jamilchahineaub/FireFightingUAVF26-27/cl415/cad/interference.md

# CAD interference check

Pairs whose bounding boxes overlap, with the volume their solids share.

| part A | part B | shared volume [mm^3] |
|---|---|---|
| fuselage | left_wing | 0.000 |
| fuselage | right_wing | 0.000 |
| fuselage | v_stab | 0.000 |
| fuselage | rudder | 0.000 |
| fuselage | water_tank | 0.000 |
| fuselage | eq_avionics | 0.000 |
| fuselage | eq_elevator_servo | 0.000 |
| fuselage | eq_rudder_servo | 0.000 |
| fuselage | eq_door_servo | 0.000 |
| left_wing | right_wing | 0.000 |
| left_wing | left_aileron | 0.000 |
| left_wing | left_nacelle | 0.000 |
| left_wing | left_float | 0.000 |
| left_wing | eq_left_aileron_servo | 0.000 |
| right_wing | right_aileron | 0.000 |
| right_wing | right_nacelle | 0.000 |
| right_wing | right_float | 0.000 |
| right_wing | eq_right_aileron_servo | 0.000 |
| h_stab | elevator | 0.000 |
| h_stab | v_stab | 0.000 |
| elevator | v_stab | 0.000 |
| elevator | rudder | 0.000 |
| v_stab | rudder | 0.000 |
| left_nacelle | left_propeller | 0.000 |
| left_nacelle | eq_left_motor | 0.000 |
| left_nacelle | eq_left_esc | 0.000 |
| right_nacelle | right_propeller | 0.000 |
| right_nacelle | eq_right_motor | 0.000 |
| right_nacelle | eq_right_esc | 0.000 |

Largest overlap: 0.000 mm^3.
