jamilchahineaub/FireFightingUAVF26-27/cl415/flight_params/airfoils/report.md

# Airfoil properties (XFOIL)

XFOIL 6.99, viscous, free transition with Ncrit = 9 (clean model surface, low-turbulence air), incompressible. Polars in `polars/*.csv`, plots in `plots/`. Generated by `run_xfoil.py`.

## Reynolds numbers in flight

| V [m/s] | wing (c = 0.278 m) | h-stab (c = 0.239 m) | fin MAC (0.310 m) |
|---:|---:|---:|---:|
| 12 | 228k | 196k | 255k |
| 14 | 267k | 229k | 297k |
| 17 | 324k | 278k | 361k |
| 20 | 381k | 327k | 424k |
| 25 | 476k | 409k | 530k |
| 30 | 571k | 491k | 637k |

## NACA 4417 (wing)

| Re | alpha_L0 [deg] | cl_alpha [/rad] | cl_max | alpha at cl_max [deg] | cl_min | cd_min | cl at cd_min | cm0 (c/4) | x_ac/c | (cl/cd)max | cl at (cl/cd)max |
|---:|---:|---:|---:|---:|---:|---:|---:|---:|---:|---:|---:|
| 150k | -3.90 | 7.035 | 1.513 | 13.50 | -0.712 | 0.0144 | 0.405 | -0.1008 | 0.257 | 58 | 1.31 |
| 200k | -4.19 | 6.497 | 1.512 | 13.50 | -0.859 | 0.0122 | 0.441 | -0.1044 | 0.246 | 68 | 1.35 |
| 300k | -4.32 | 6.135 | 1.528 | 14.00 | -0.959 | 0.0103 | 0.475 | -0.1053 | 0.236 | 81 | 1.26 |
| 400k | -4.32 | 6.034 | 1.547 | 14.50 | -1.011 | 0.0094 | 0.551 | -0.1046 | 0.234 | 90 | 1.25 |
| 500k | -4.31 | 6.046 | 1.567 | 14.75 | -1.020 | 0.0088 | 0.580 | -0.1039 | 0.236 | 97 | 1.21 |
| 600k | -4.30 | 6.085 | 1.584 | 14.75 | -1.021 | 0.0084 | 0.610 | -0.1033 | 0.237 | 103 | 1.23 |

Aileron effectiveness at Re 300k, hinge at 0.750 c (cf/c = 0.250), deflections -10, -5, +5, +10 deg: dcl/ddelta = 3.100 /rad, dcm/ddelta = -0.479 /rad, tau = 0.505 (thin-airfoil theory says 0.609). Extra drag at 10 deg: 0.0061.

## NACA 0016 (htail)

| Re | alpha_L0 [deg] | cl_alpha [/rad] | cl_max | alpha at cl_max [deg] | cl_min | cd_min | cl at cd_min | cm0 (c/4) | x_ac/c | (cl/cd)max | cl at (cl/cd)max |
|---:|---:|---:|---:|---:|---:|---:|---:|---:|---:|---:|---:|
| 150k | 0.00 | 7.826 | 1.203 | 13.75 | -1.200 | 0.0135 | -0.000 | -0.0000 | 0.267 | 45 | 0.80 |
| 200k | 0.00 | 6.811 | 1.218 | 15.00 | -1.185 | 0.0111 | -0.000 | 0.0000 | 0.245 | 50 | 0.83 |
| 300k | 0.00 | 6.102 | 1.242 | 17.50 | -1.184 | 0.0091 | -0.000 | 0.0000 | 0.226 | 57 | 0.86 |
| 400k | 0.00 | 6.007 | 1.249 | 17.75 | -1.211 | 0.0082 | -0.000 | 0.0000 | 0.226 | 63 | 0.94 |
| 500k | 0.00 | 6.047 | 1.278 | 16.00 | -1.242 | 0.0077 | -0.000 | 0.0000 | 0.230 | 67 | 0.99 |
| 600k | 0.00 | 6.095 | 1.313 | 16.25 | -1.267 | 0.0073 | -0.000 | 0.0000 | 0.233 | 70 | 1.00 |

Elevator effectiveness at Re 300k, hinge at 0.603 c (cf/c = 0.397), deflections -10, -5, +5, +10 deg: dcl/ddelta = 4.603 /rad, dcm/ddelta = -0.557 /rad, tau = 0.754 (thin-airfoil theory says 0.746). Extra drag at 10 deg: 0.0067.

## NACA 0012 (fin)

| Re | alpha_L0 [deg] | cl_alpha [/rad] | cl_max | alpha at cl_max [deg] | cl_min | cd_min | cl at cd_min | cm0 (c/4) | x_ac/c | (cl/cd)max | cl at (cl/cd)max |
|---:|---:|---:|---:|---:|---:|---:|---:|---:|---:|---:|---:|
| 150k | 0.00 | 8.687 | 1.052 | 11.00 | -1.052 | 0.0119 | -0.382 | 0.0000 | 0.296 | 43 | 0.62 |
| 200k | 0.00 | 8.284 | 1.107 | 12.50 | -1.107 | 0.0102 | 0.000 | 0.0000 | 0.286 | 47 | 0.62 |
| 300k | 0.00 | 7.497 | 1.161 | 13.75 | -1.159 | 0.0077 | 0.000 | -0.0000 | 0.270 | 53 | 0.65 |
| 400k | -0.00 | 6.829 | 1.204 | 14.00 | -1.203 | 0.0067 | 0.000 | 0.0000 | 0.253 | 58 | 0.67 |
| 500k | -0.00 | 6.454 | 1.236 | 14.75 | -1.228 | 0.0062 | 0.000 | -0.0000 | 0.243 | 62 | 0.74 |
| 600k | -0.00 | 6.254 | 1.261 | 14.75 | -1.252 | 0.0059 | 0.000 | -0.0000 | 0.237 | 65 | 0.79 |

Rudder effectiveness at Re 300k, hinge at 0.620 c (cf/c = 0.380), deflections -10, -5, +5, +10 deg: dcl/ddelta = 4.565 /rad, dcm/ddelta = -0.585 /rad, tau = 0.609 (thin-airfoil theory says 0.732). Extra drag at 10 deg: 0.0061.
