jamilchahineaub/FireFightingUAVF26-27/docs/versions.md

# Pinned versions

Fill in on the simulation machine and keep current. Every log and result refers to this file.

| Item | Value | Recorded by | Date |
|---|---|---|---|
| OS (`lsb_release -a`) | | | |
| PX4-Autopilot tag (`git describe --tags`) | | | |
| PX4-gazebo-models submodule commit | | | |
| Gazebo (`gz sim --versions`) | | | |
| gz-sim includes AdvancedLiftDrag Cem fix (#3695) | | | |
| QGroundControl | | | |
| MATLAB / Octave | Octave 8.4.0 (dev container) | Jamil | 2026-09-28 |
| Python + pyyaml + jinja2 | Python 3.11 | Jamil | 2026-09-28 |
| params.yaml schema | 1 | Jamil | 2026-09-28 |
