jamilchahineaub/FireFightingUAVF26-27/cl415/cad/renders/cad_views.png

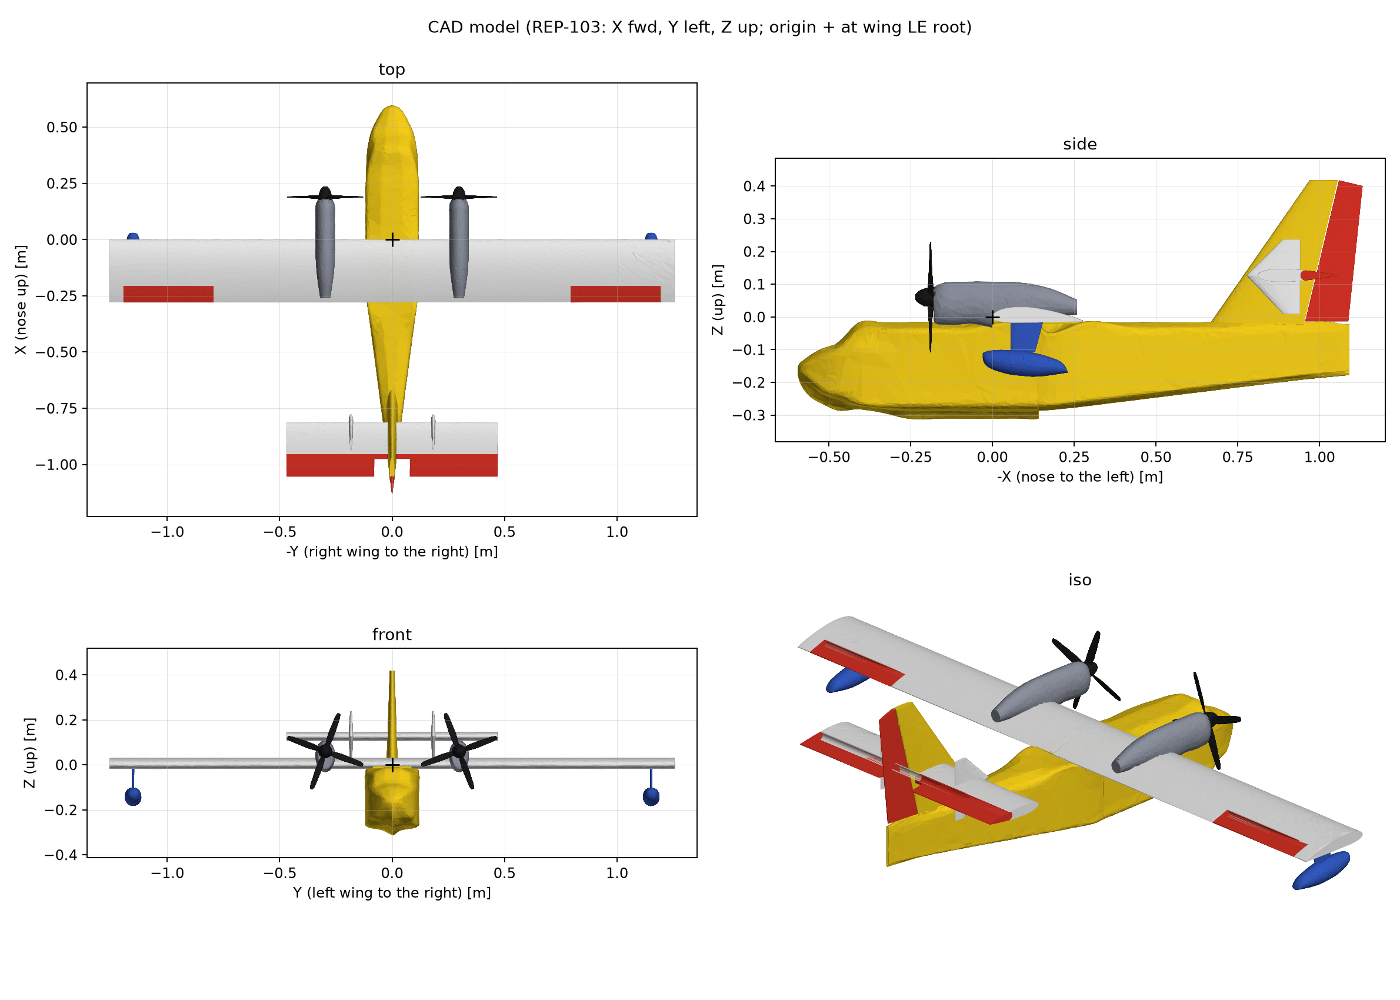
cl415/cad/renders/cad_views.png
