jamilchahineaub/FireFightingUAVF26-27/cl415/cad/renders/cad_vs_obj_front.png

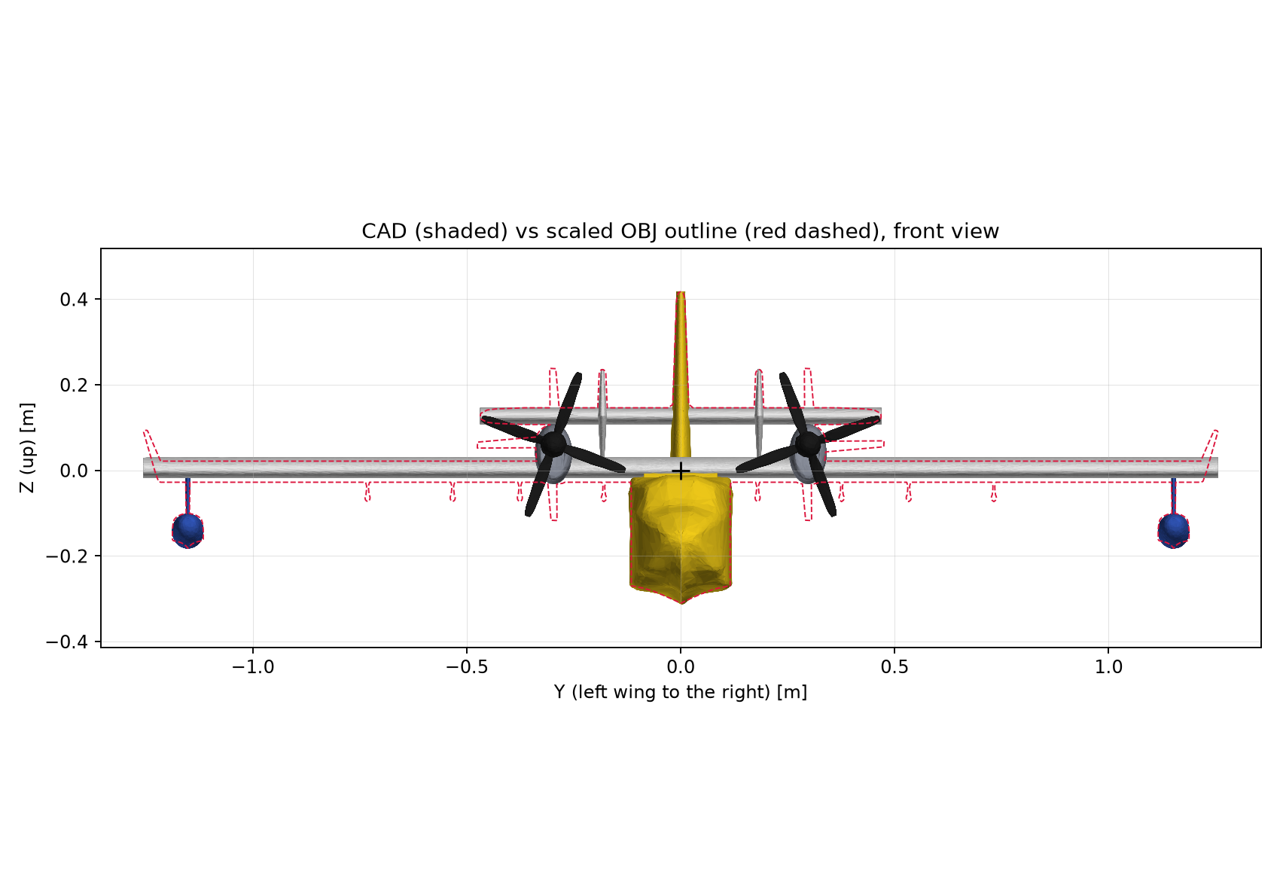
cl415/cad/renders/cad_vs_obj_front.png
