jamilchahineaub/FireFightingUAVF26-27/cl415/cad/renders/cad_vs_obj_side.png

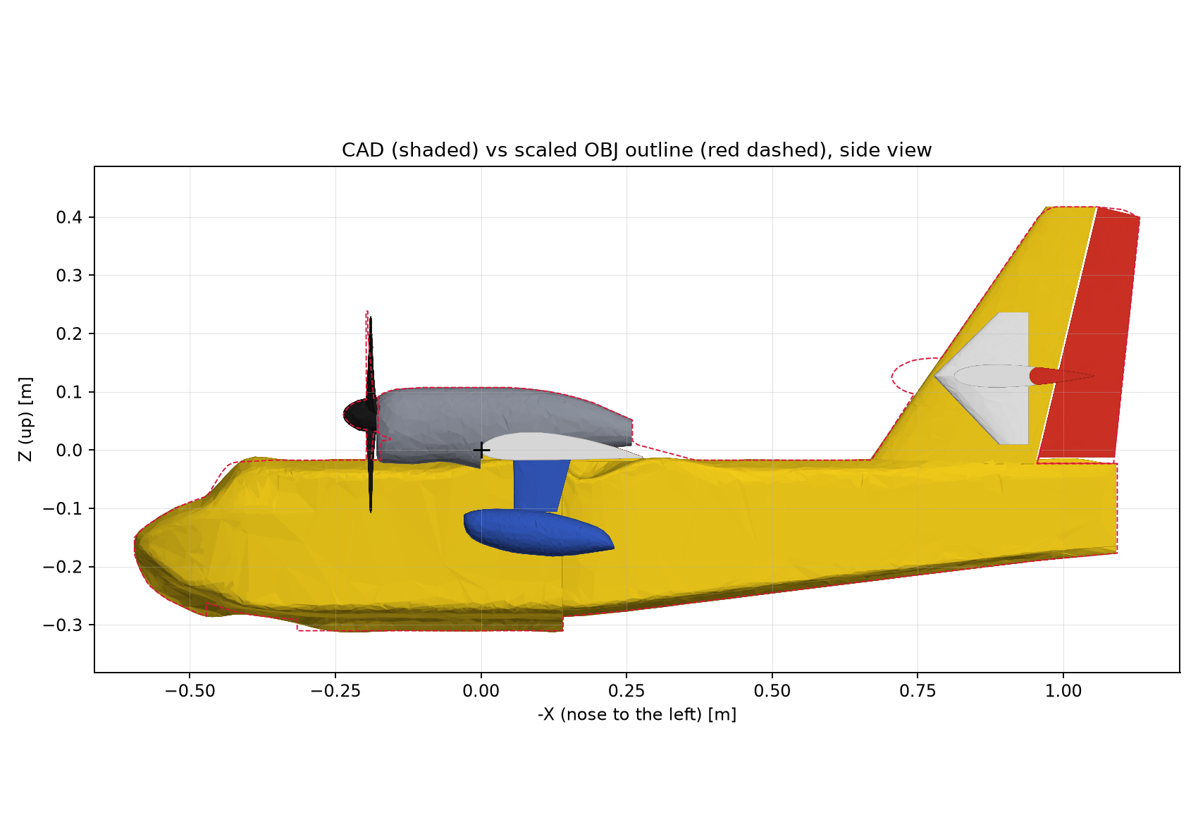
cl415/cad/renders/cad_vs_obj_side.png
