jamilchahineaub/FireFightingUAVF26-27/cl415/flight_params/airfoils/plots/fin_0012.png

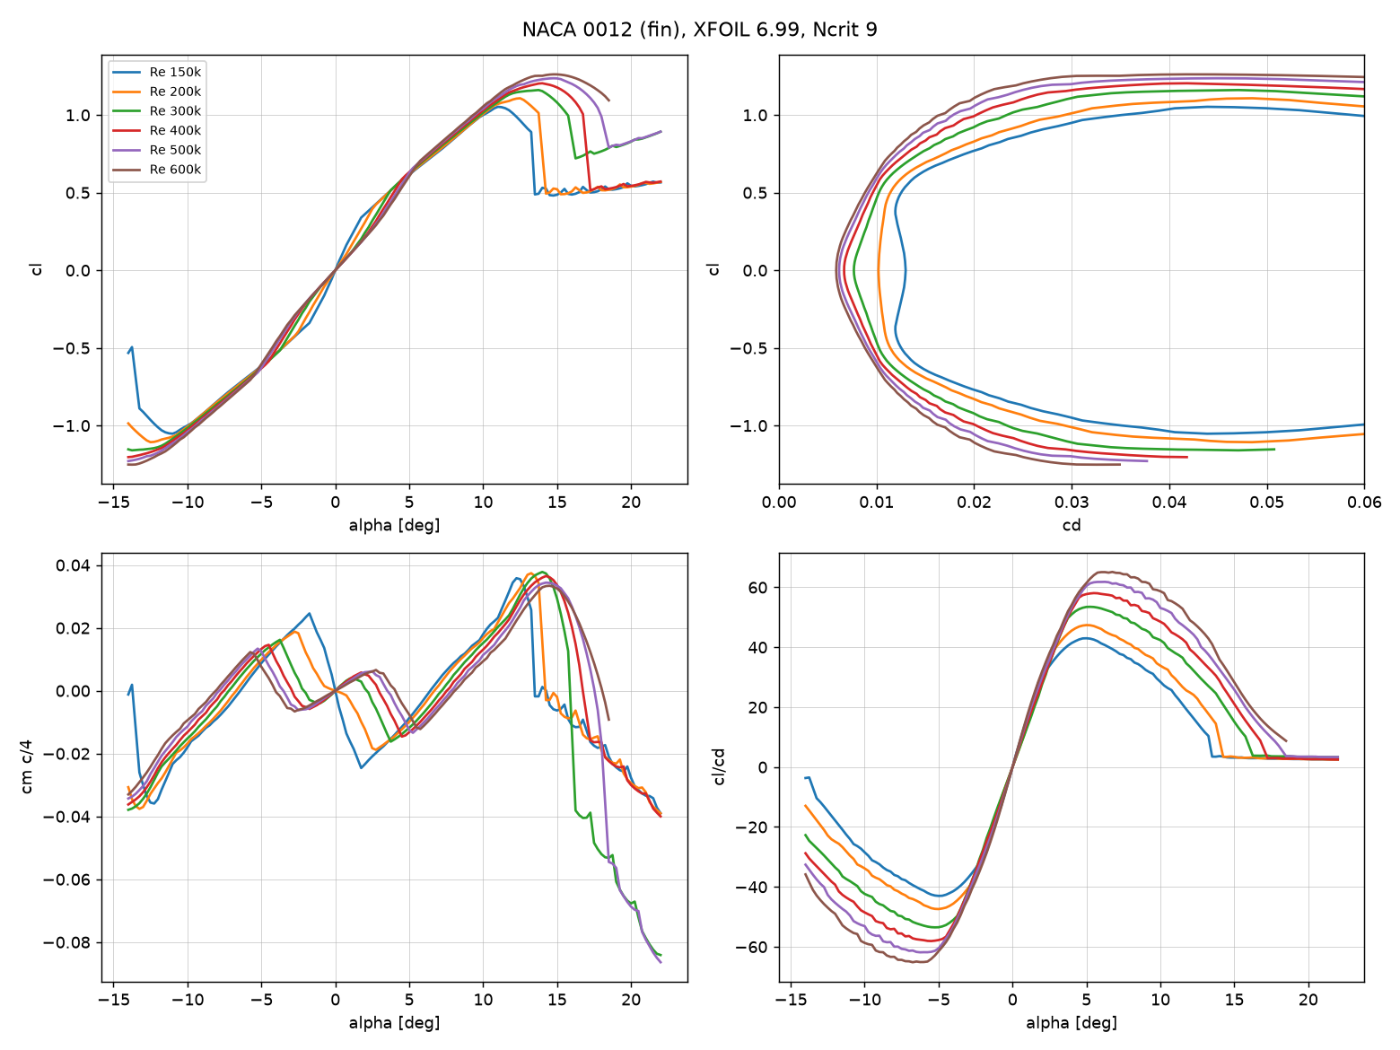
cl415/flight_params/airfoils/plots/fin_0012.png
