jamilchahineaub/FireFightingUAVF26-27/cl415/flight_params/airfoils/plots/htail_0016.png

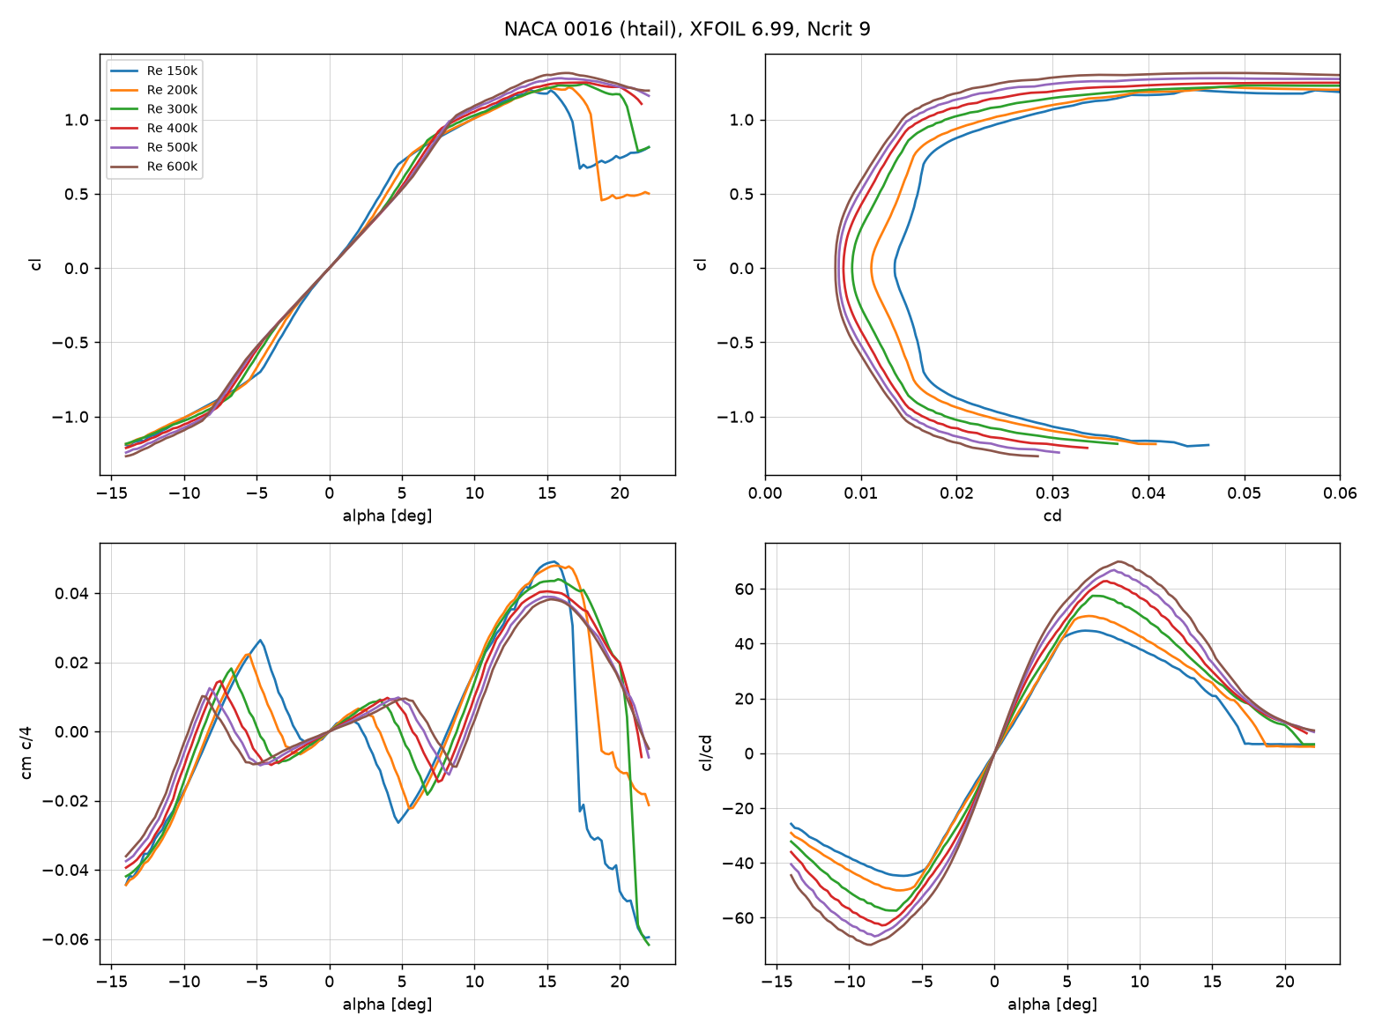
cl415/flight_params/airfoils/plots/htail_0016.png
