jamilchahineaub/FireFightingUAVF26-27/cl415/flight_params/airfoils/plots/wing_4417.png

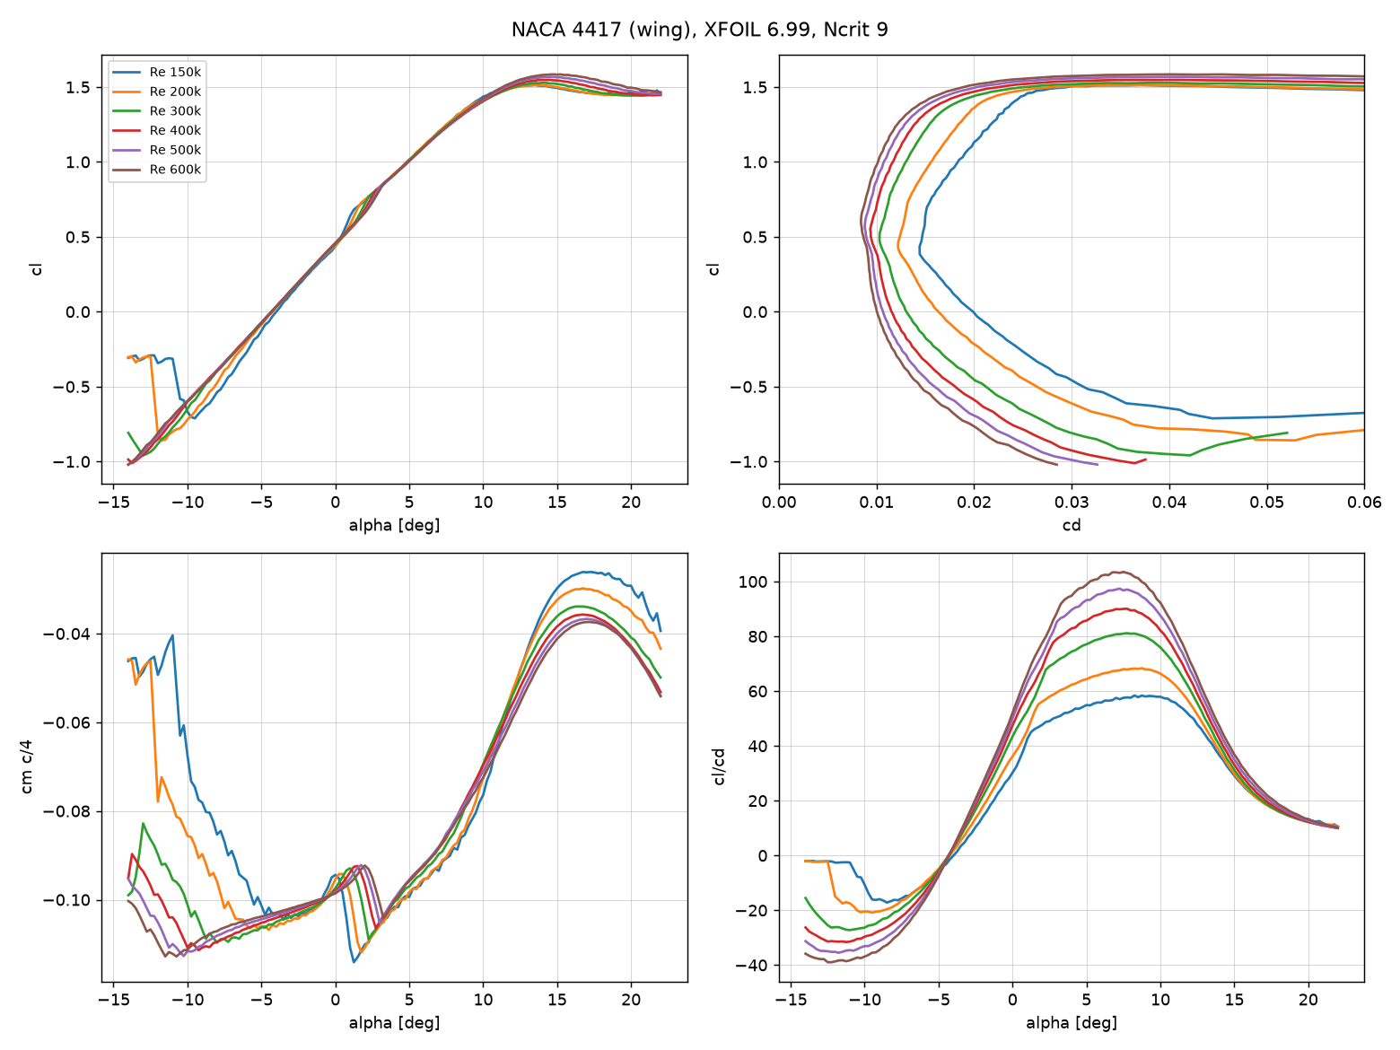
cl415/flight_params/airfoils/plots/wing_4417.png
