jamilchahineaub/FireFightingUAVF26-27/cl415/flight_params/plots/aero_and_thrust.png

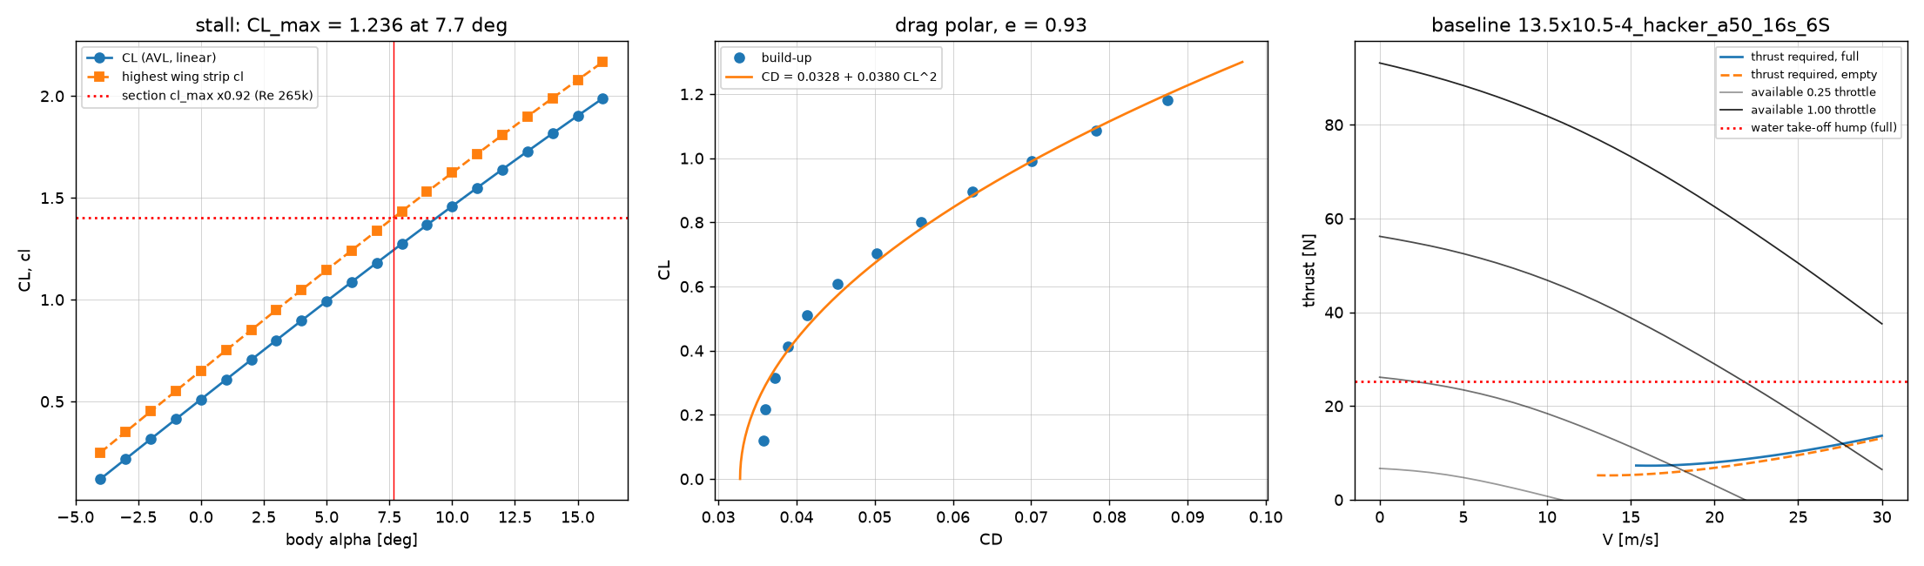
cl415/flight_params/plots/aero_and_thrust.png
