jamilchahineaub/FireFightingUAVF26-27/cl415/obj_inspect/renders/obj_raw_axes.png

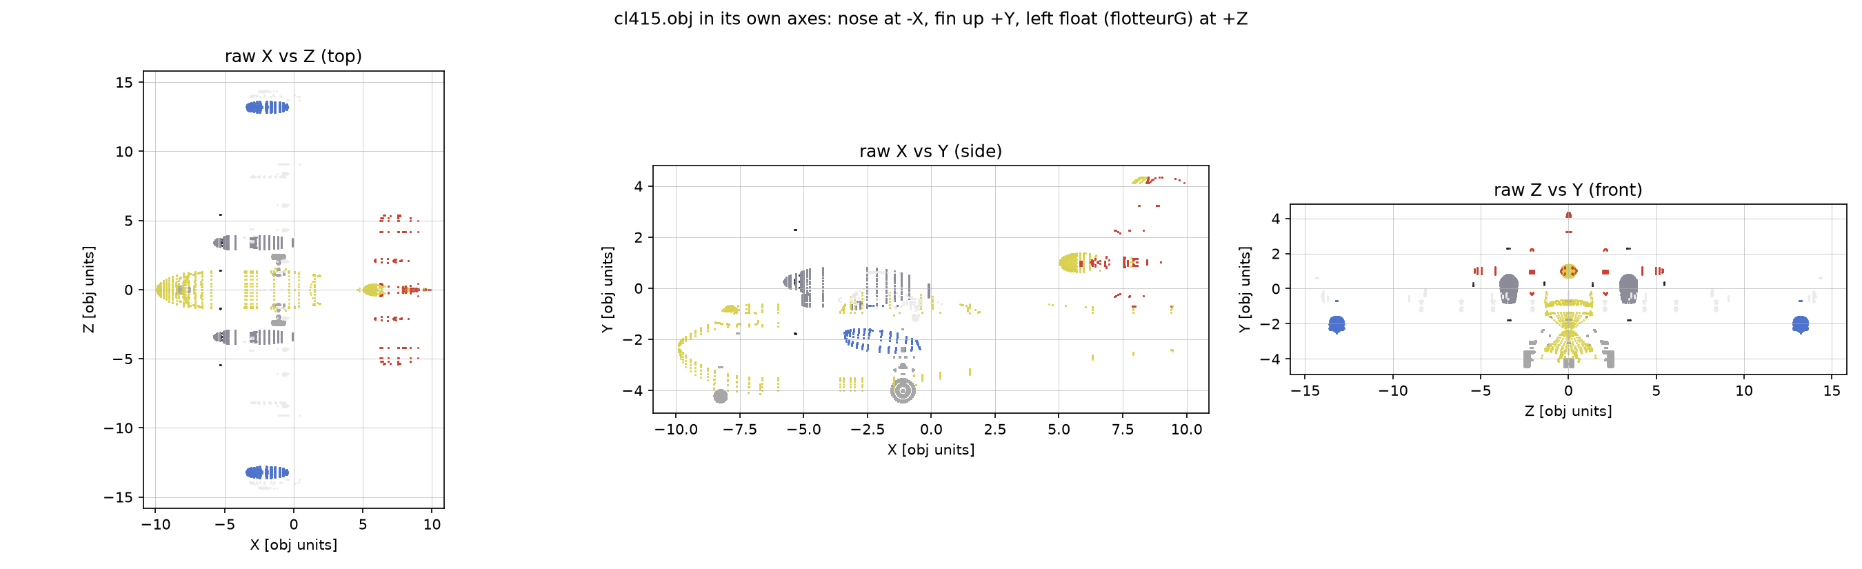
cl415/obj_inspect/renders/obj_raw_axes.png
