jamilchahineaub/FireFightingUAVF26-27/cl415/obj_inspect/renders/obj_top.png

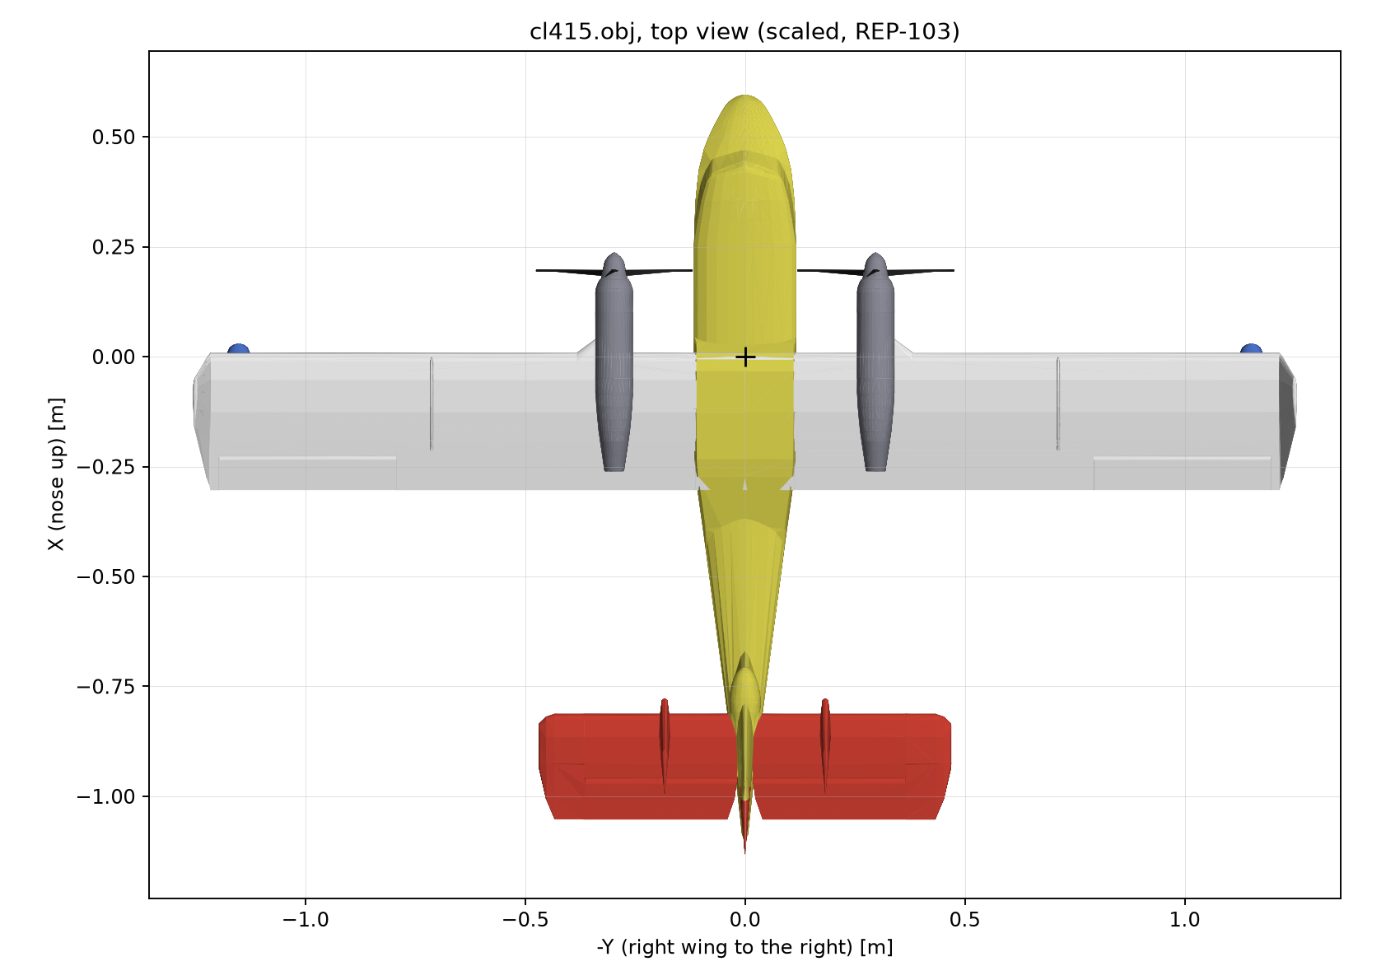
cl415/obj_inspect/renders/obj_top.png
