jamilchahineaub/FireFightingUAVF26-27/cl415/obj_inspect/renders/obj_views.png

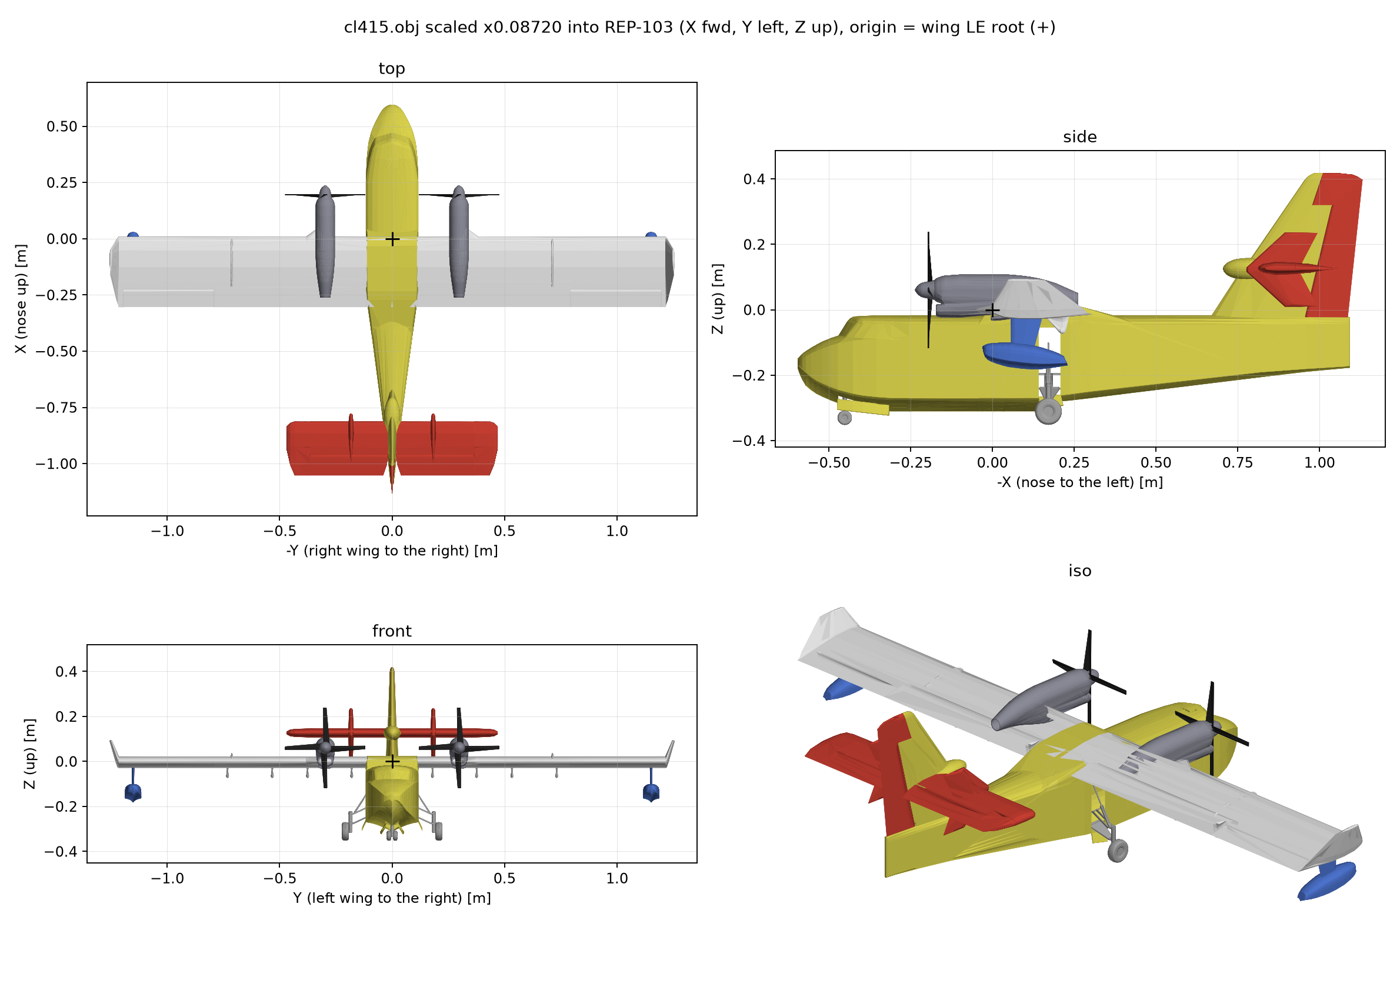
cl415/obj_inspect/renders/obj_views.png
