jamilchahineaub/FireFightingUAVF26-27/cl415/cad/cl415_assembly.step

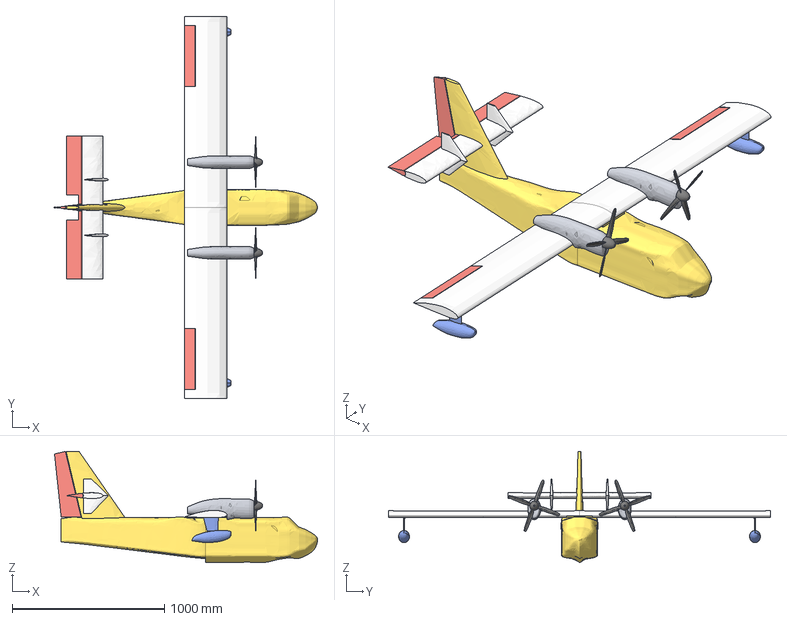
[picture p16: CAD file, 2026-10-05]
cl415/cad/cl415_assembly.step
1726.2 x 2510.0 x 729.7 mm
fuselage
left_wing
right_wing
left_aileron
right_aileron
h_stab
elevator
v_stab
rudder
left_nacelle
right_nacelle
left_propeller
right_propeller
left_float
right_float
water_tank
eq_left_motor
eq_right_motor
eq_left_esc
eq_right_esc
eq_left_aileron_servo
eq_right_aileron_servo
eq_avionics
eq_elevator_servo
eq_rudder_servo
eq_door_servo
