jamilchahineaub/FireFightingUAVF26-27/cl415/cad/build/hull_outer.step

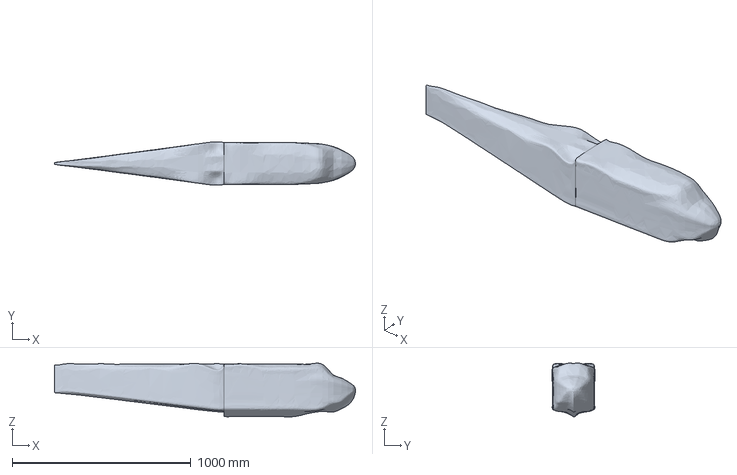
[picture p17: CAD file, 2026-10-05]
cl415/cad/build/hull_outer.step
1685.1 x 243.5 x 300.9 mm
