jamilchahineaub/FireFightingUAVF26-27/cl415/cad/parts/eq_left_aileron_servo.step

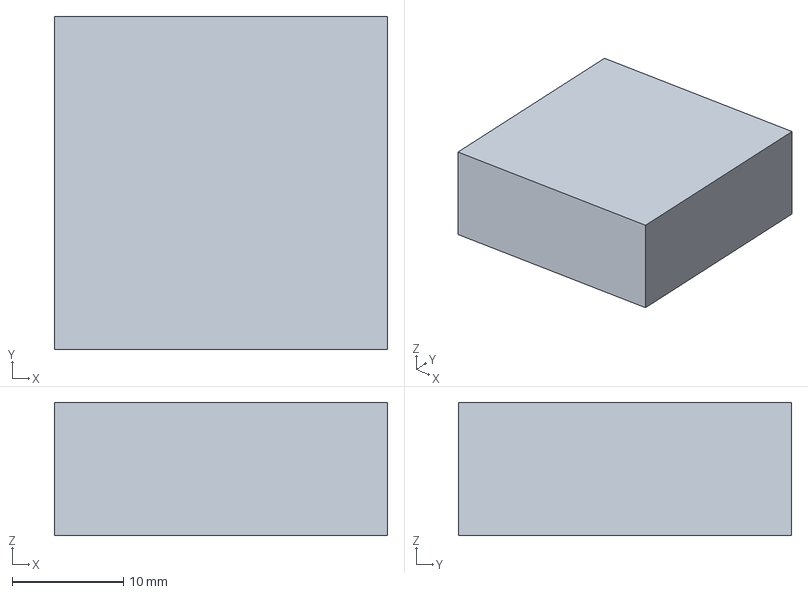
[picture p18: CAD file, 2026-10-05]
cl415/cad/parts/eq_left_aileron_servo.step
30.0 x 30.0 x 12.0 mm
