jamilchahineaub/FireFightingUAVF26-27/cl415/cl415.obj

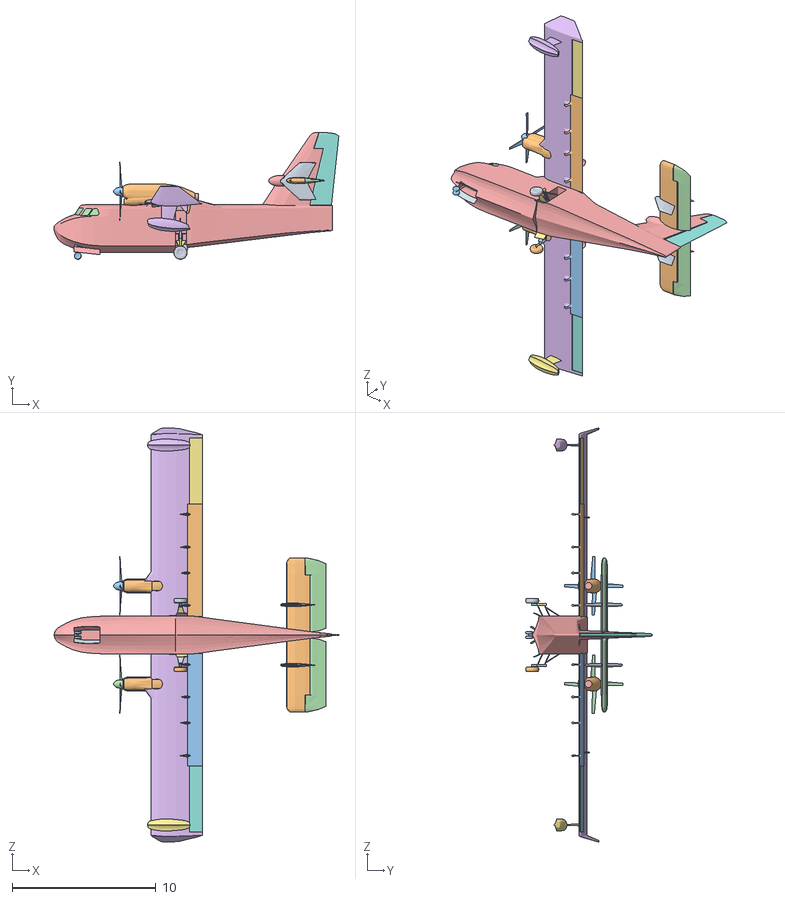
[picture p19: CAD file, 2026-10-05]
cl415/cl415.obj
19.8 x 8.82 x 28.8
porteD
voletG_voletG.mesh
voletD_voletD.mesh
vitres_vitres.mesh
trous_trous.mesh
trappeG_trappeG.mesh
trappeD_trappeD.mesh
surailes_surailes.mesh
roueG_roueG.mesh
roueD_roueD.mesh
roueA_roueA.mesh
profondeur_profondeur.mesh
porteG_porteG.mesh
parapG2_parapG2.mesh
parapG1_parapG1.mesh
parapD2_parapD2.mesh
parapD1_parapD1.mesh
moteurs_moteurs.mesh
heliceG_heliceG.mesh
heliceD_heliceD.mesh
fuselage_fuselage.mesh
flotteurG_flotteurG.mesh
flotteurD_flotteurD.mesh
direction_direction.mesh
derive2_derive2.mesh
derive_derive.mesh
bolG_bolG.mesh
bolD_bolD.mesh
axeG4_axeG4.mesh
axeG3_axeG3.mesh
axeG2_axeG2.mesh
axeG1_axeG1.mesh
axeD4_axeD4.mesh
axeD3_axeD3.mesh
axeD2_axeD2.mesh
axeD1_axeD1.mesh
axeA_axeA.mesh
ailes_ailes.mesh
aileronG_aileronG.mesh
aileronD_aileronD.mesh
planchet_planchet.mesh
inttour_inttour.mesh
interieur_interieur.mesh
cotes.001_cotes.mesh.001
cloison_cloison.mesh
vitre.012_vitre.mesh.012
tmp.002_tmp.mesh.002
tmp.001_tmp.mesh.001
vitre.011_vitre.mesh.011
vitre.010_vitre.mesh.010
tmp_tmp.mesh
face.005_face.mesh.005
fond.009_fond.mesh.009
needle.005_needle.mesh.005
vitre.009_vitre.mesh.009
vitre.008_vitre.mesh.008
needle.004_needle.mesh.004
fond.008_fond.mesh.008
face.004_face.mesh.004
bouton.001_bouton.mesh.001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
