jamilchahineaub/FireFightingUAVF26-27/cl415/cl415_description/meshes/left_nacelle.stl

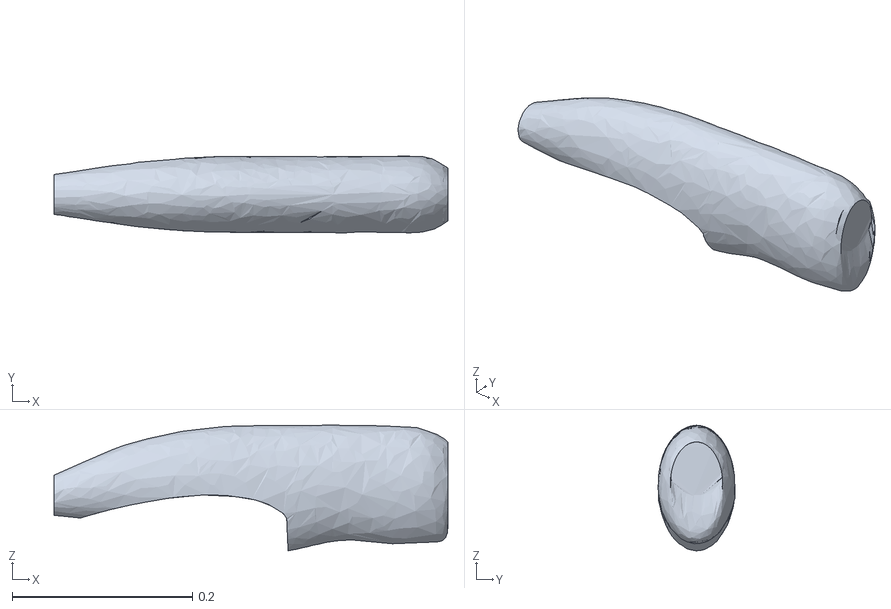
[picture p20: CAD file, 2026-10-05]
cl415/cl415_description/meshes/left_nacelle.stl
0.437 x 0.0851 x 0.139
