jamilchahineaub/FireFightingUAVF26-27/cl415/cad/build/hull_cavity.step

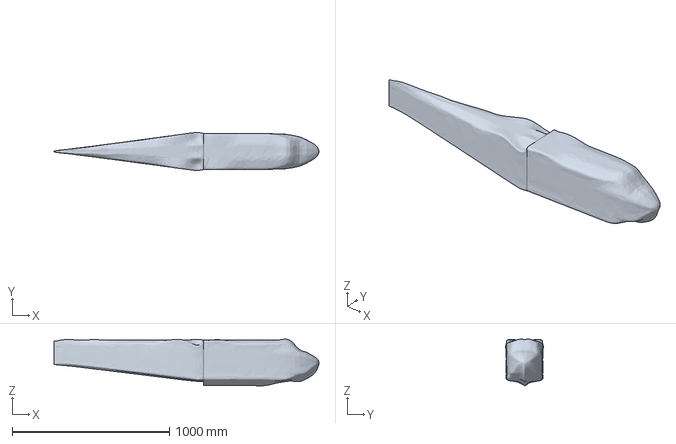
[picture p21: CAD file, 2026-10-05]
cl415/cad/build/hull_cavity.step
1685.1 x 240.5 x 297.0 mm
