jamilchahineaub/FireFightingUAVF26-27/cl415/cad/parts/eq_elevator_servo.step

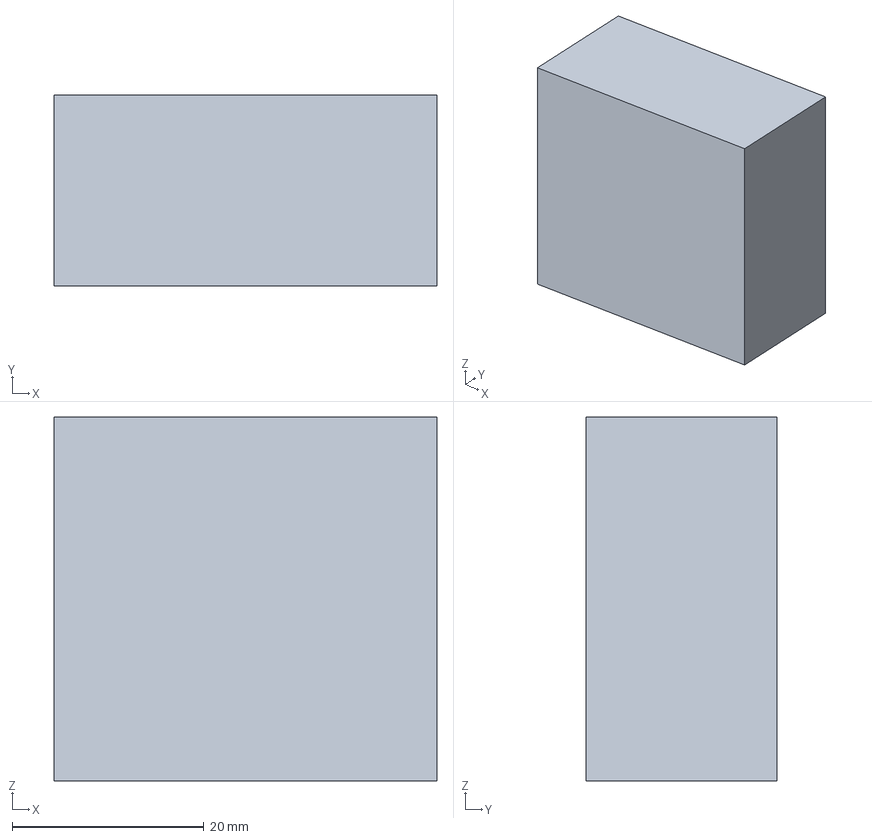
[picture p22: CAD file, 2026-10-05]
cl415/cad/parts/eq_elevator_servo.step
40.0 x 20.0 x 38.0 mm
