jamilchahineaub/FireFightingUAVF26-27/cl415/cl415_description/meshes/left_float.stl

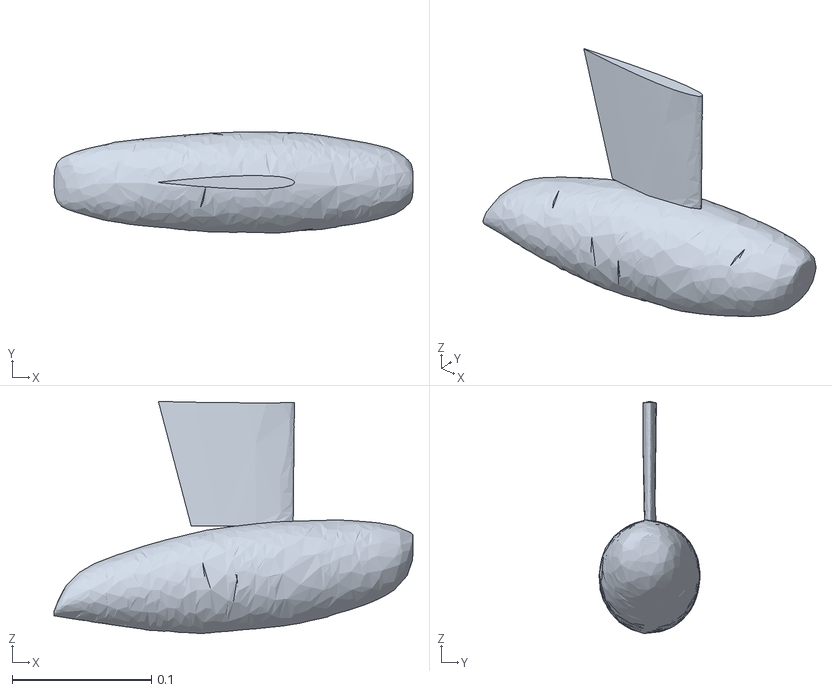
[picture p23: CAD file, 2026-10-05]
cl415/cl415_description/meshes/left_float.stl
0.257 x 0.0724 x 0.166
