jamilchahineaub/FireFightingUAVF26-27/cl415/cad/parts/left_float.step

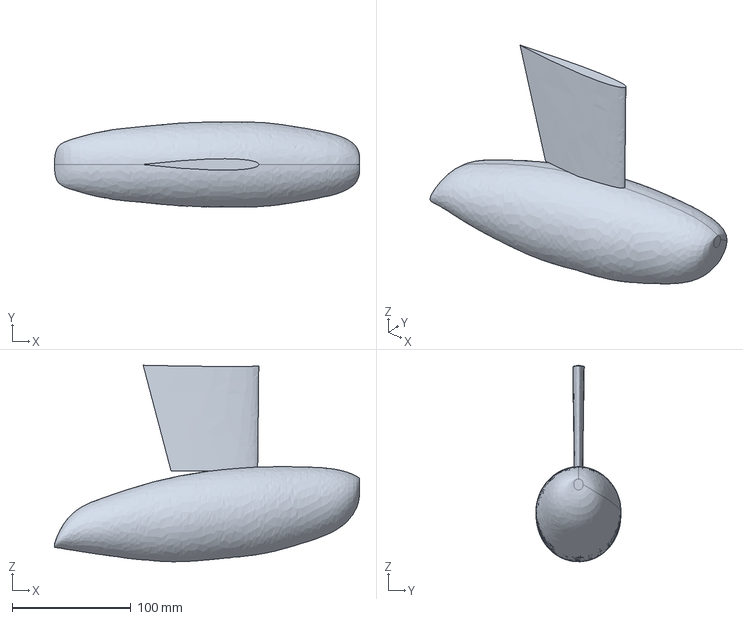
[picture p24: CAD file, 2026-10-05]
cl415/cad/parts/left_float.step
257.4 x 72.0 x 165.9 mm
