jamilchahineaub/FireFightingUAVF26-27/cl415/cl415_description/meshes/right_aileron.stl

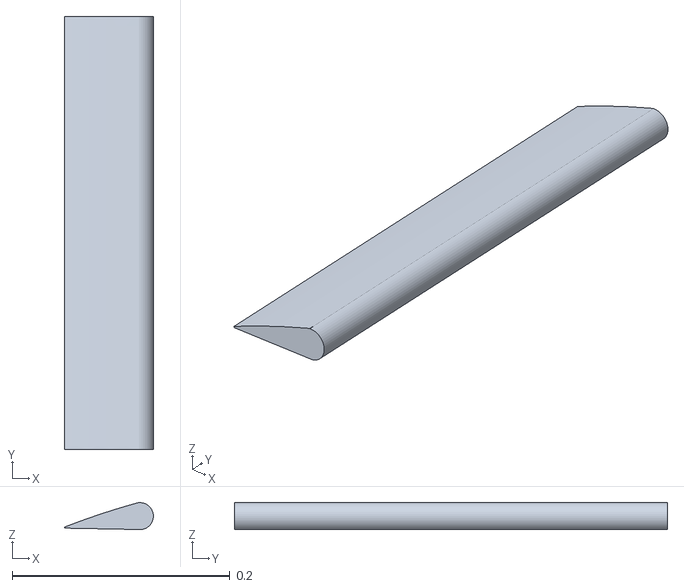
[picture p25: CAD file, 2026-10-05]
cl415/cl415_description/meshes/right_aileron.stl
0.0816 x 0.398 x 0.025
