jamilchahineaub/FireFightingUAVF26-27/cl415/cad/parts/eq_right_esc.step

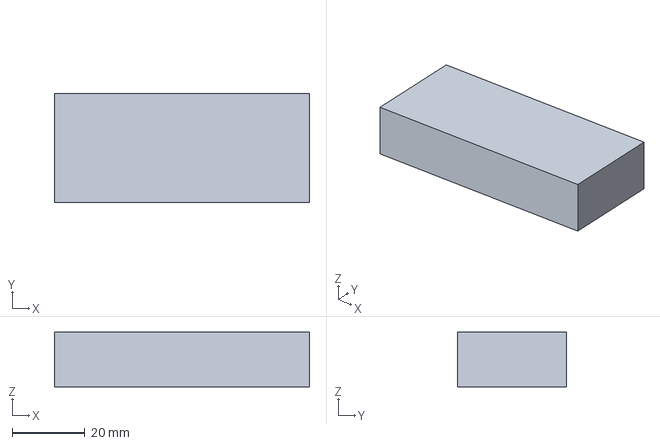
[picture p26: CAD file, 2026-10-05]
cl415/cad/parts/eq_right_esc.step
70.0 x 30.0 x 15.0 mm
