jamilchahineaub/FireFightingUAVF26-27/cl415/cad/parts/fuselage.step

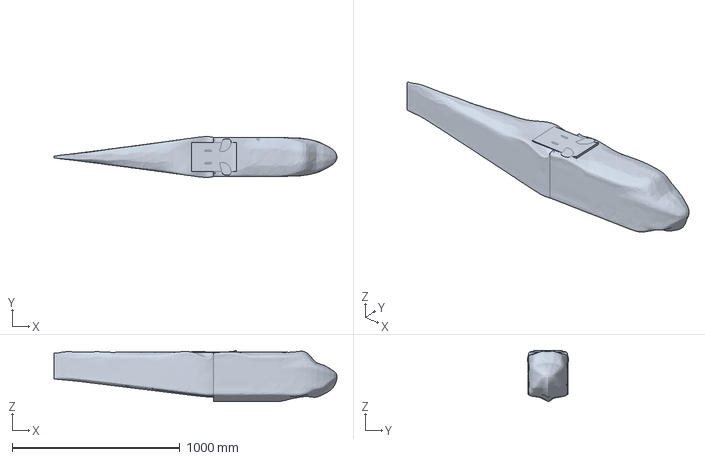
[picture p27: CAD file, 2026-10-05]
cl415/cad/parts/fuselage.step
1685.1 x 243.6 x 306.2 mm
