jamilchahineaub/FireFightingUAVF26-27/cl415/cl415_description/meshes/water_tank.stl

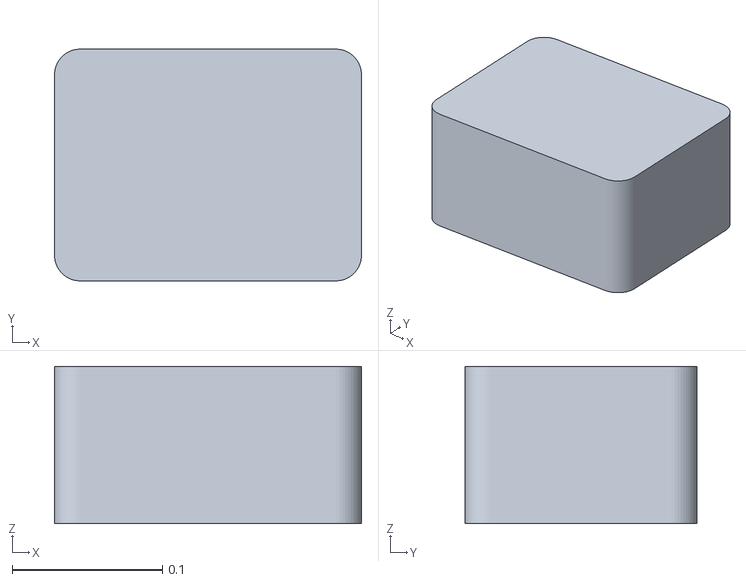
[picture p28: CAD file, 2026-10-05]
cl415/cl415_description/meshes/water_tank.stl
0.204 x 0.154 x 0.105
