jamilchahineaub/FireFightingUAVF26-27/cl415/cad/parts/left_wing.step

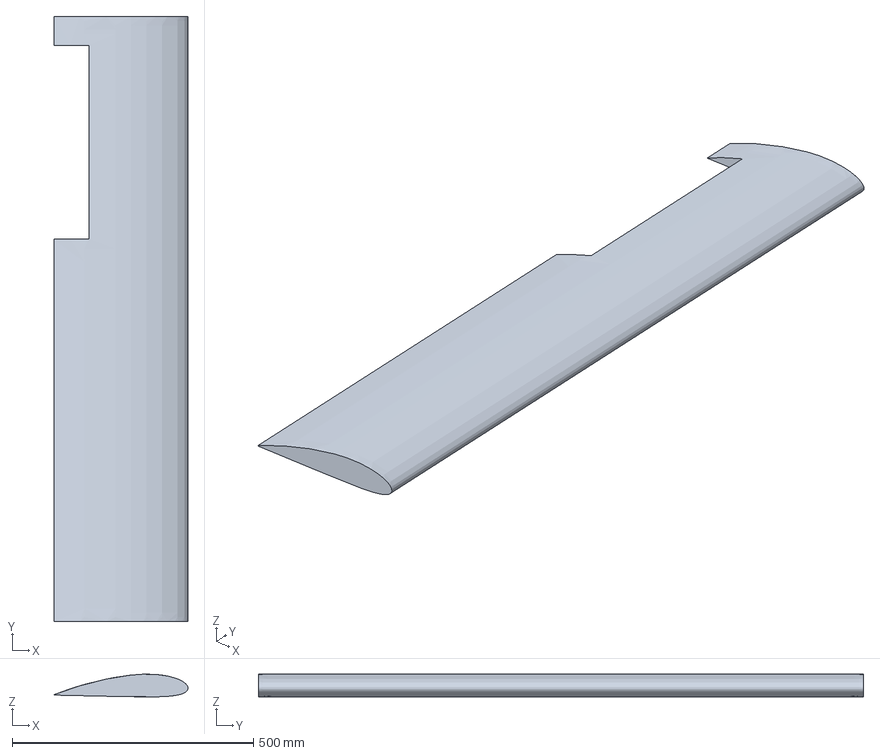
[picture p29: CAD file, 2026-10-05]
cl415/cad/parts/left_wing.step
277.9 x 1255.0 x 47.2 mm
