jamilchahineaub/FireFightingUAVF26-27/cl415/cl415_description/meshes/right_nacelle.stl

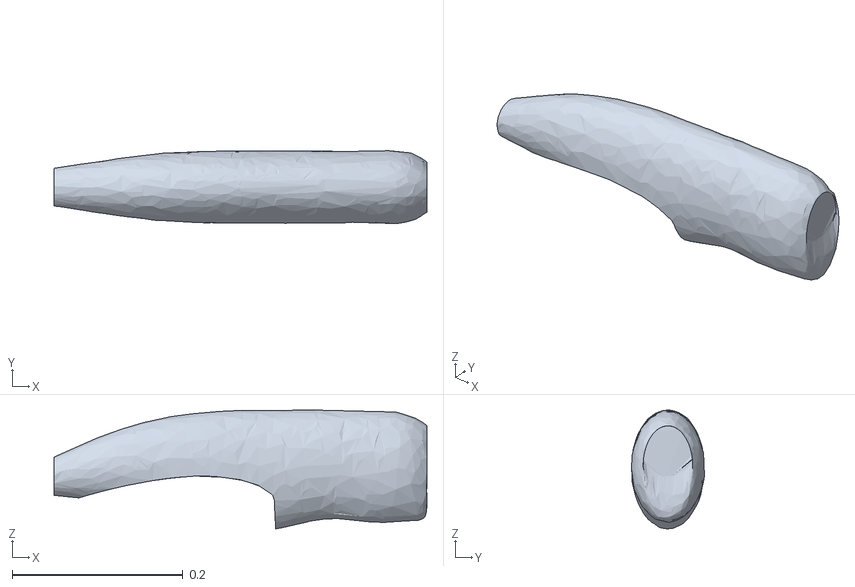
[picture p30: CAD file, 2026-10-05]
cl415/cl415_description/meshes/right_nacelle.stl
0.437 x 0.0856 x 0.139
