jamilchahineaub/FireFightingUAVF26-27/cl415/cl415_description/meshes/left_wing.stl

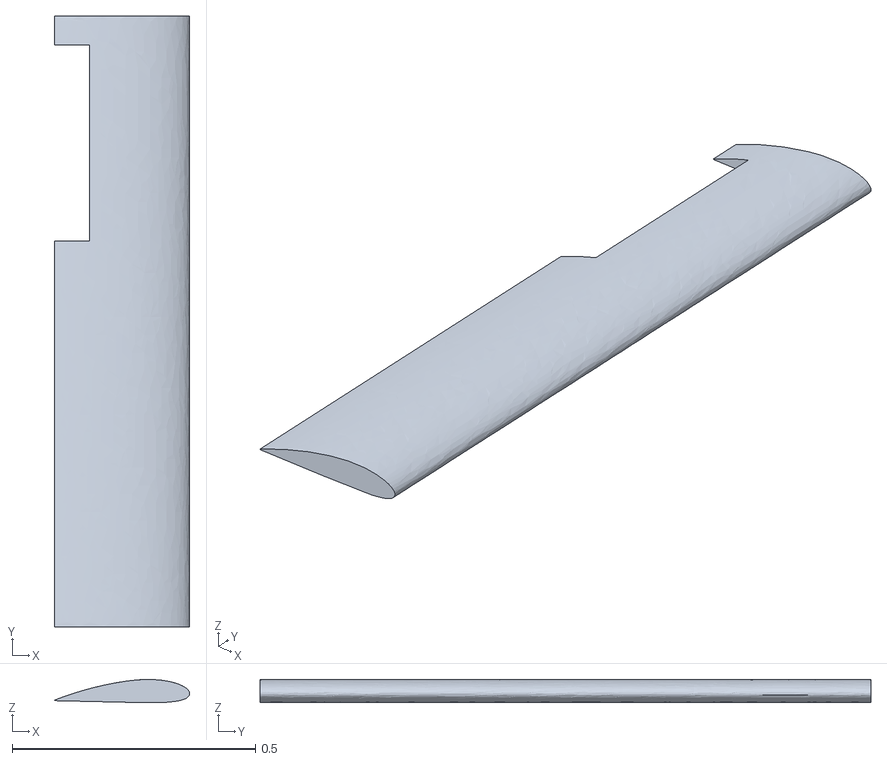
[picture p31: CAD file, 2026-10-05]
cl415/cl415_description/meshes/left_wing.stl
0.278 x 1.26 x 0.0473
