jamilchahineaub/FireFightingUAVF26-27/cl415/cl415_description/meshes/v_stab.stl

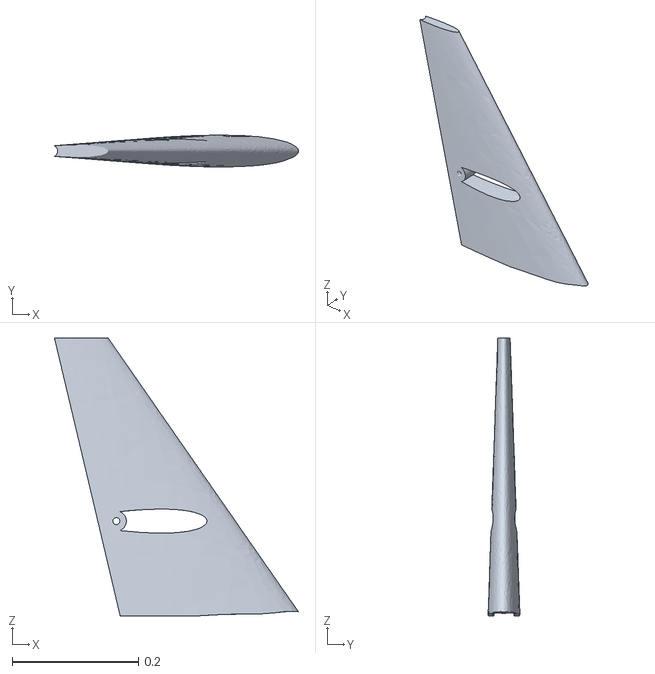
[picture p32: CAD file, 2026-10-05]
cl415/cl415_description/meshes/v_stab.stl
0.387 x 0.0506 x 0.44
