jamilchahineaub/FireFightingUAVF26-27/cl415/cad/parts/elevator.step

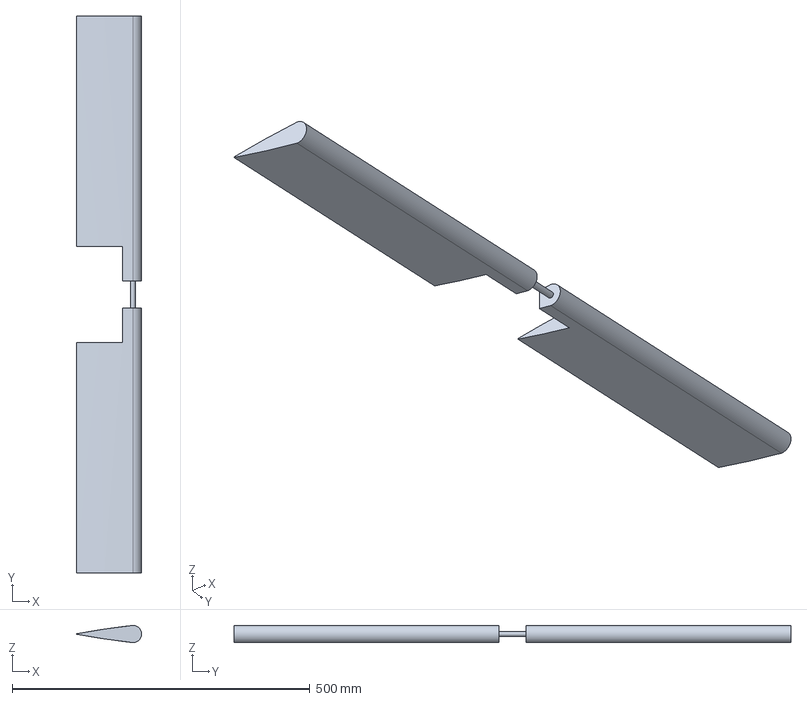
[picture p33: CAD file, 2026-10-05]
cl415/cad/parts/elevator.step
109.5 x 936.0 x 29.0 mm
