jamilchahineaub/FireFightingUAVF26-27/cl415/cl415_description/meshes/right_propeller.stl

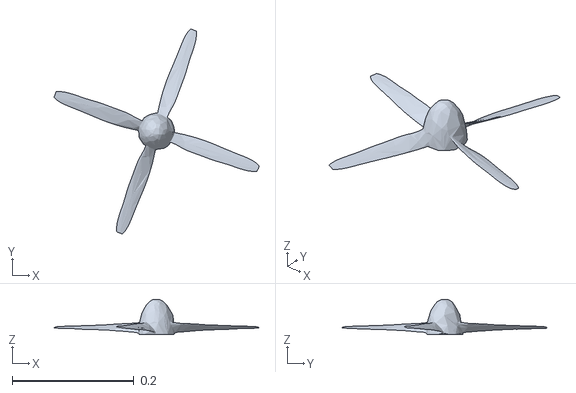
[picture p34: CAD file, 2026-10-05]
cl415/cl415_description/meshes/right_propeller.stl
0.337 x 0.337 x 0.058
