jamilchahineaub/FireFightingUAVF26-27/cl415/cad/parts/h_stab.step

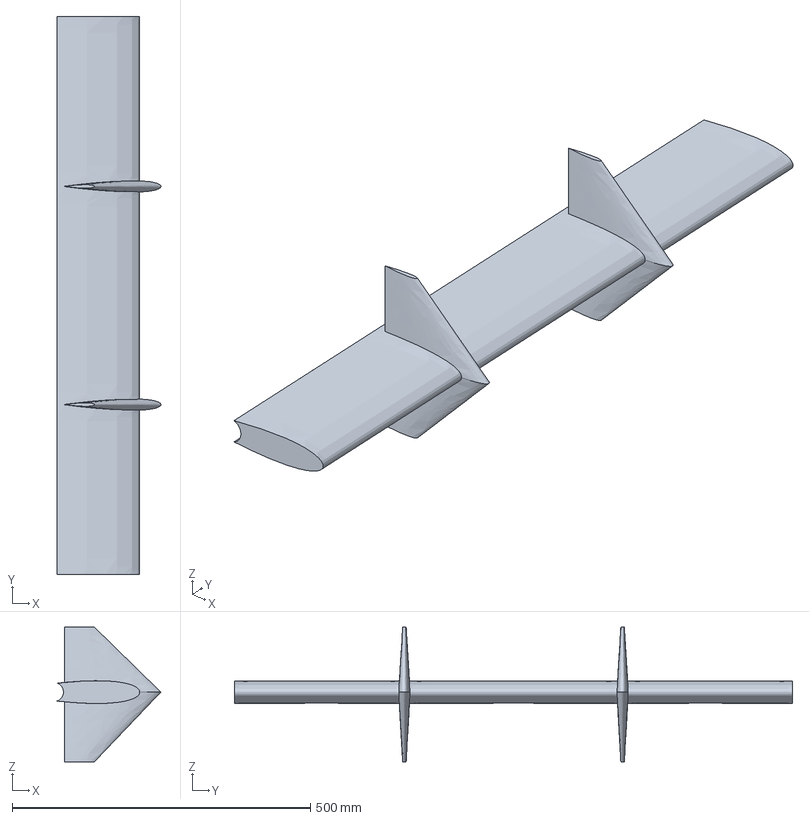
[picture p35: CAD file, 2026-10-05]
cl415/cad/parts/h_stab.step
174.1 x 936.0 x 226.0 mm
