jamilchahineaub/FireFightingUAVF26-27/cl415/cad/parts/left_nacelle.step

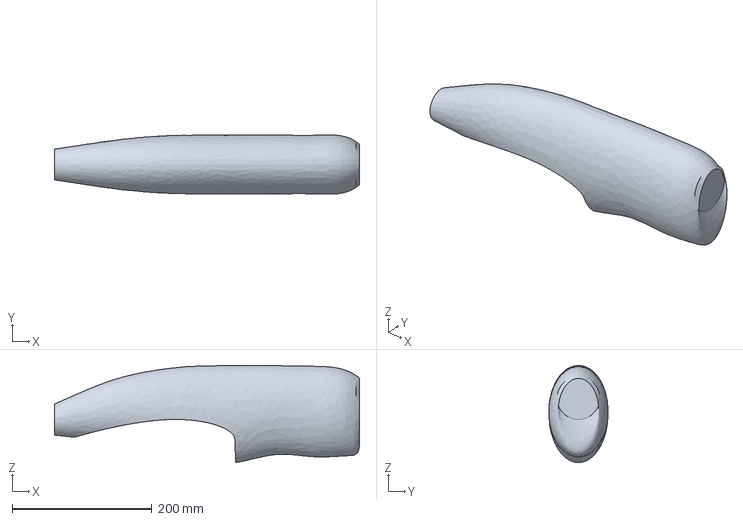
[picture p37: CAD file, 2026-10-05]
cl415/cad/parts/left_nacelle.step
437.0 x 85.1 x 139.1 mm
