jamilchahineaub/FireFightingUAVF26-27/cl415/cl415_description/meshes/rudder.stl

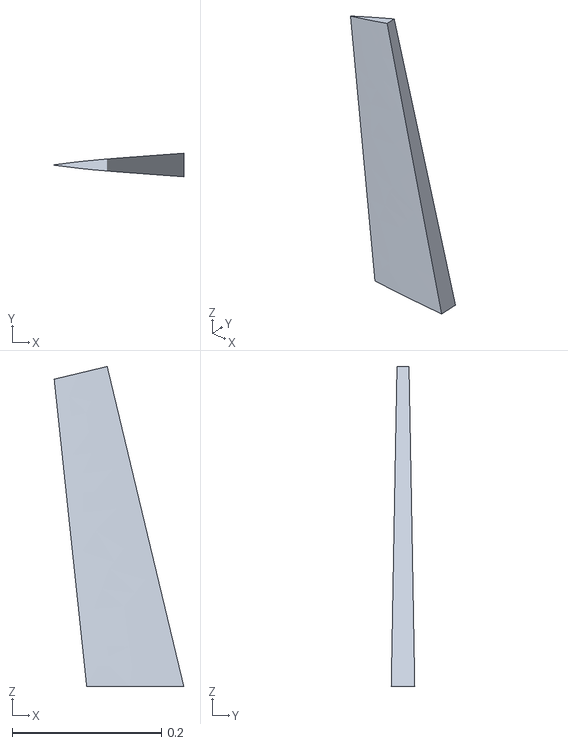
[picture p38: CAD file, 2026-10-05]
cl415/cl415_description/meshes/rudder.stl
0.174 x 0.0316 x 0.429
