jamilchahineaub/FireFightingUAVF26-27/cl415/cad/parts/water_3L.step

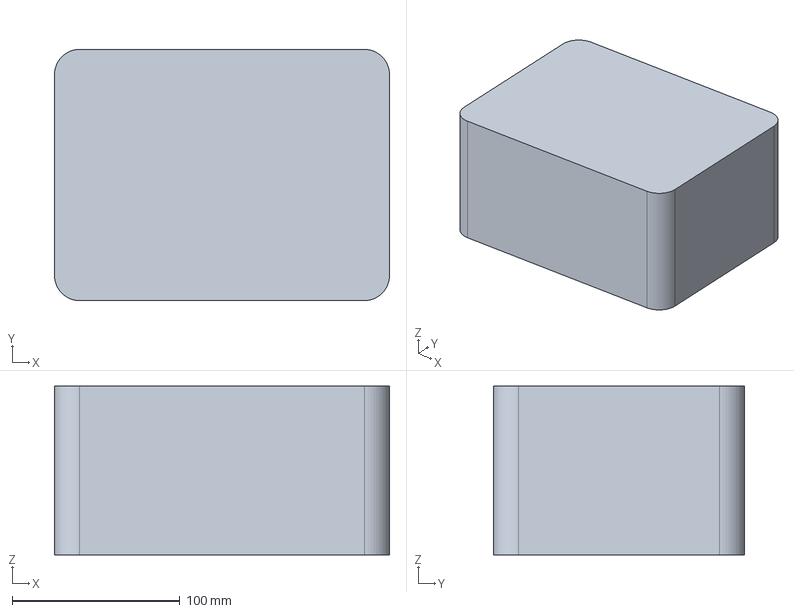
[picture p39: CAD file, 2026-10-05]
cl415/cad/parts/water_3L.step
200.0 x 150.0 x 100.6 mm
