jamilchahineaub/FireFightingUAVF26-27/cl415/cad/parts/v_stab.step

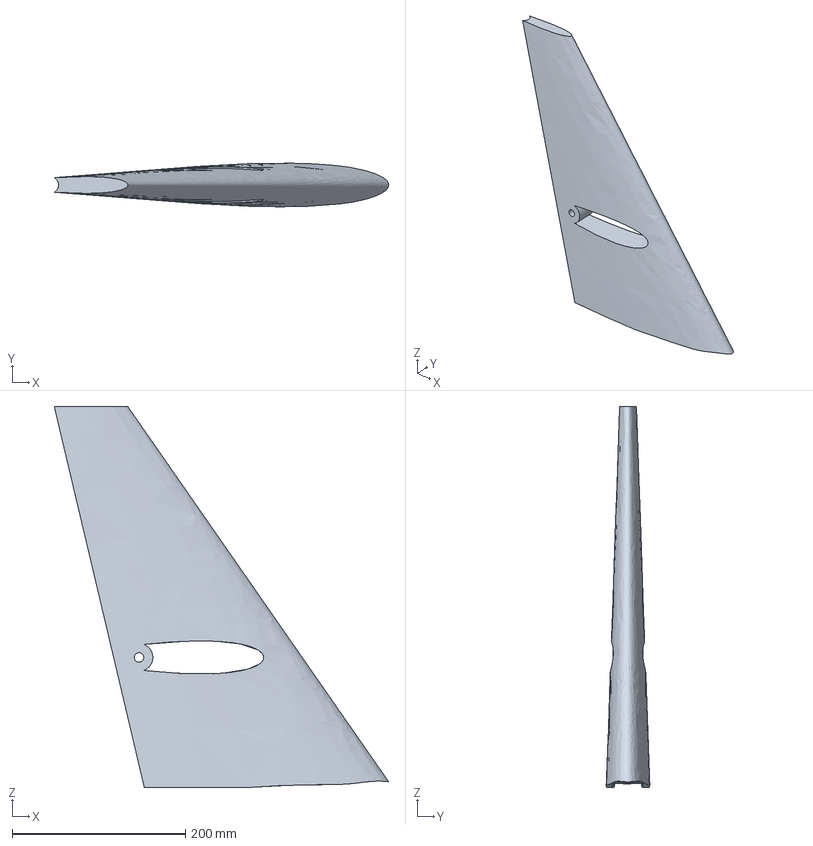
[picture p40: CAD file, 2026-10-05]
cl415/cad/parts/v_stab.step
386.6 x 50.5 x 440.3 mm
