jamilchahineaub/FireFightingUAVF26-27/cl415/cl415_description/meshes/elevator.stl

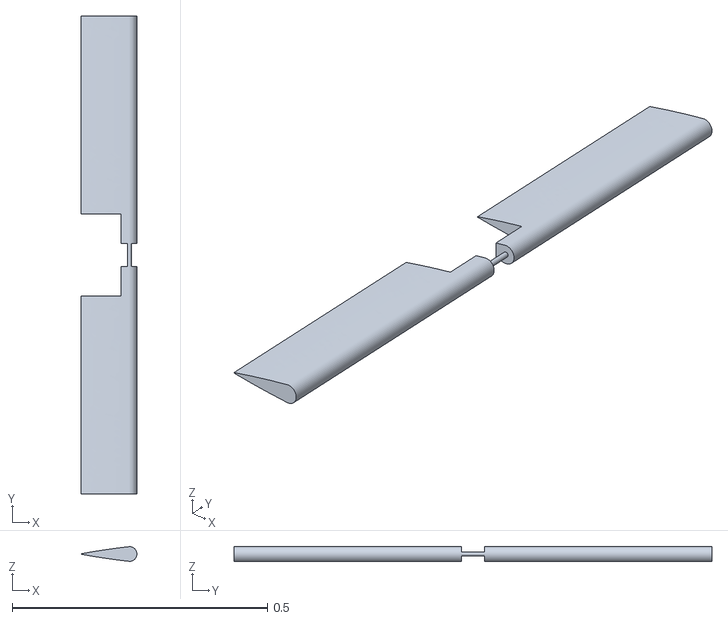
[picture p41: CAD file, 2026-10-05]
cl415/cl415_description/meshes/elevator.stl
0.109 x 0.936 x 0.029
