jamilchahineaub/FireFightingUAVF26-27/cl415/cad/parts/eq_right_motor.step

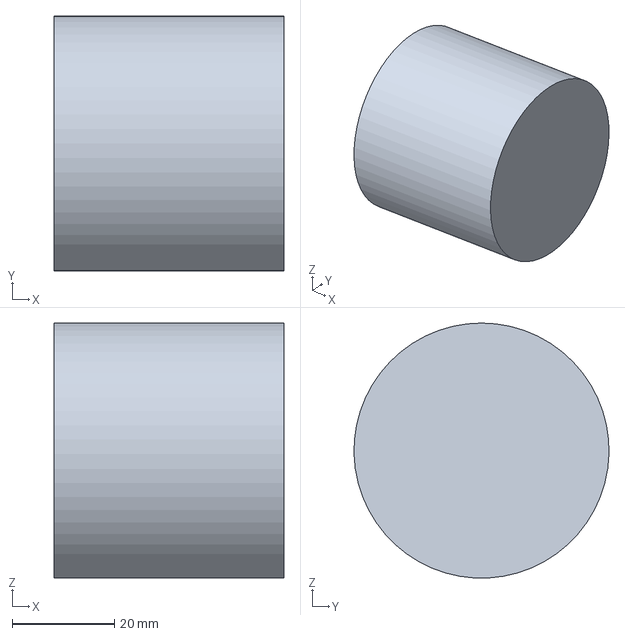
[picture p42: CAD file, 2026-10-05]
cl415/cad/parts/eq_right_motor.step
45.0 x 50.0 x 50.0 mm
