jamilchahineaub/FireFightingUAVF26-27/cl415/cl415_description/meshes/fuselage.stl

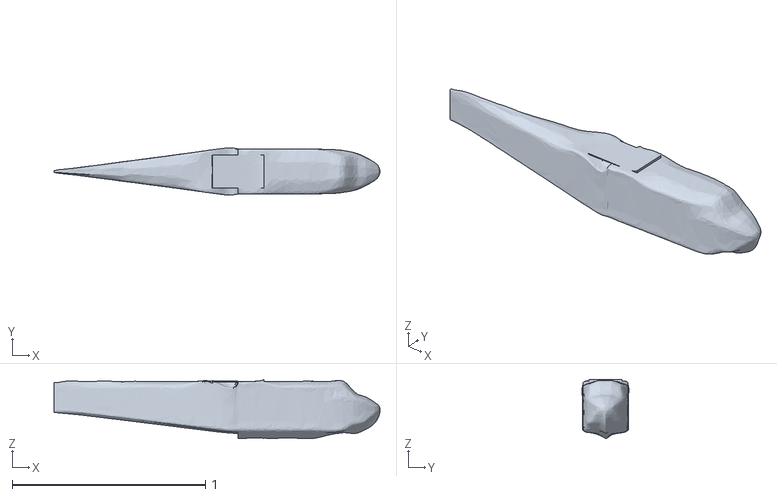
[picture p43: CAD file, 2026-10-05]
cl415/cl415_description/meshes/fuselage.stl
1.69 x 0.243 x 0.306
