jamilchahineaub/FireFightingUAVF26-27/cl415/cl415_description/meshes/h_stab.stl

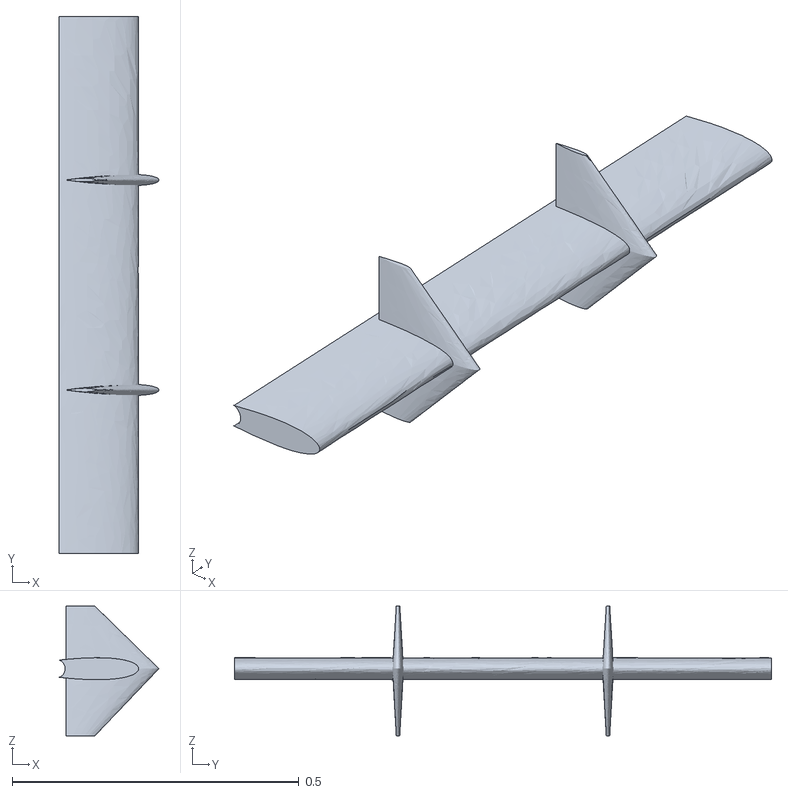
[picture p44: CAD file, 2026-10-05]
cl415/cl415_description/meshes/h_stab.stl
0.174 x 0.936 x 0.226
