jamilchahineaub/FireFightingUAVF26-27/cl415/cad/parts/eq_avionics.step

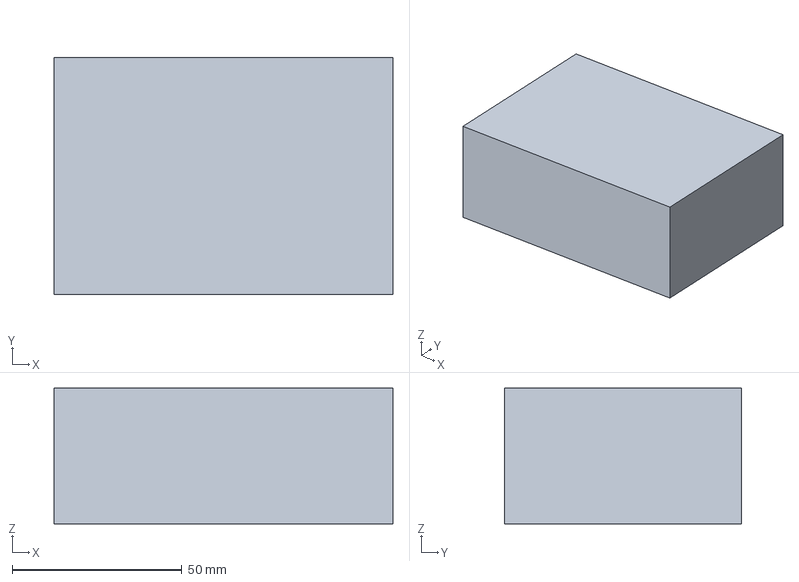
[picture p45: CAD file, 2026-10-05]
cl415/cad/parts/eq_avionics.step
100.0 x 70.0 x 40.0 mm
