jamilchahineaub/FireFightingUAVF26-27/cl415/cad/parts/left_aileron.step

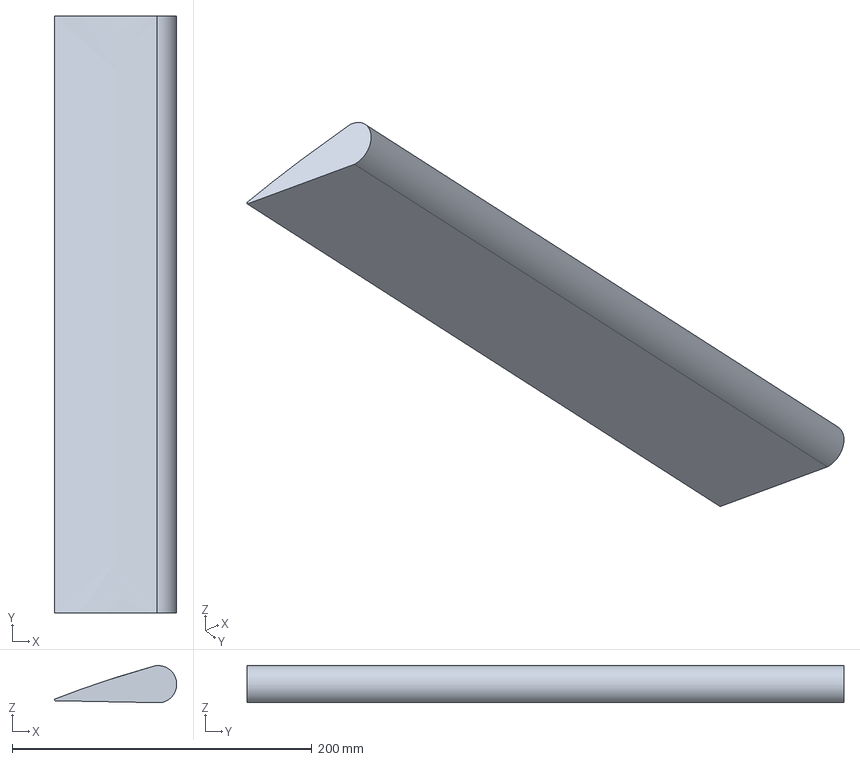
[picture p46: CAD file, 2026-10-05]
cl415/cad/parts/left_aileron.step
81.6 x 398.0 x 25.0 mm
