jamilchahineaub/FireFightingUAVF26-27/cl415/cad/parts/water_tank.step

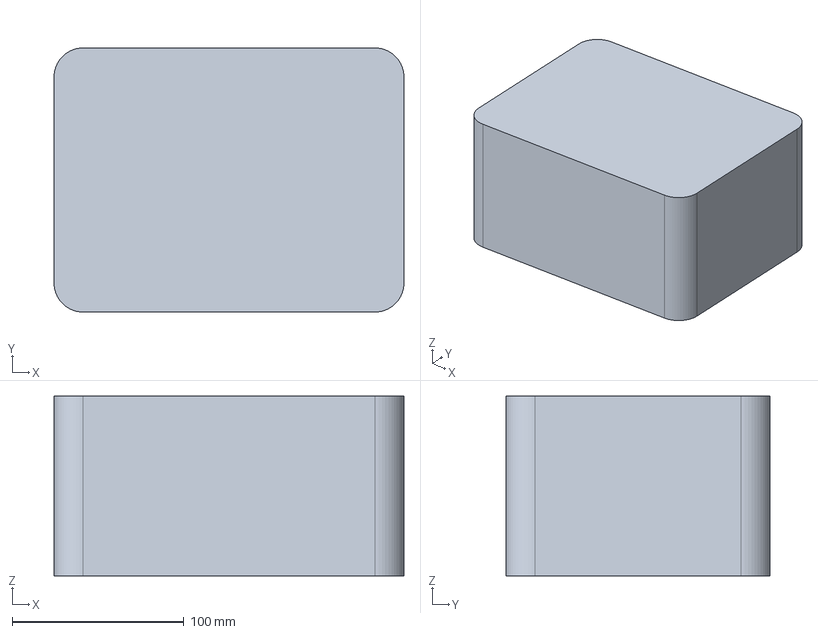
[picture p47: CAD file, 2026-10-05]
cl415/cad/parts/water_tank.step
204.0 x 154.0 x 104.6 mm
