jamilchahineaub/FireFightingUAVF26-27/cl415/cad/parts/left_propeller.step

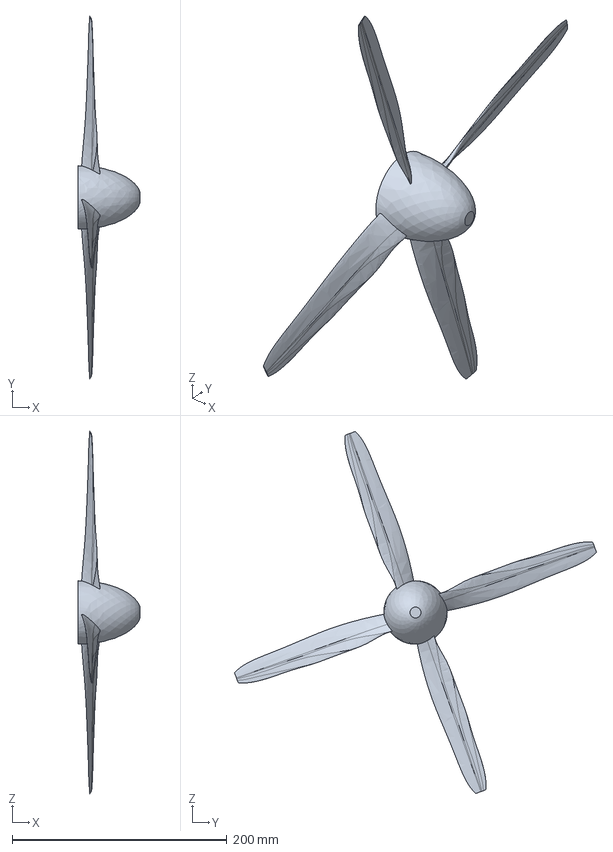
[picture p48: CAD file, 2026-10-05]
cl415/cad/parts/left_propeller.step
58.0 x 337.3 x 337.3 mm
