jamilchahineaub/FireFightingUAVF26-27/cl415/cad/parts/rudder.step

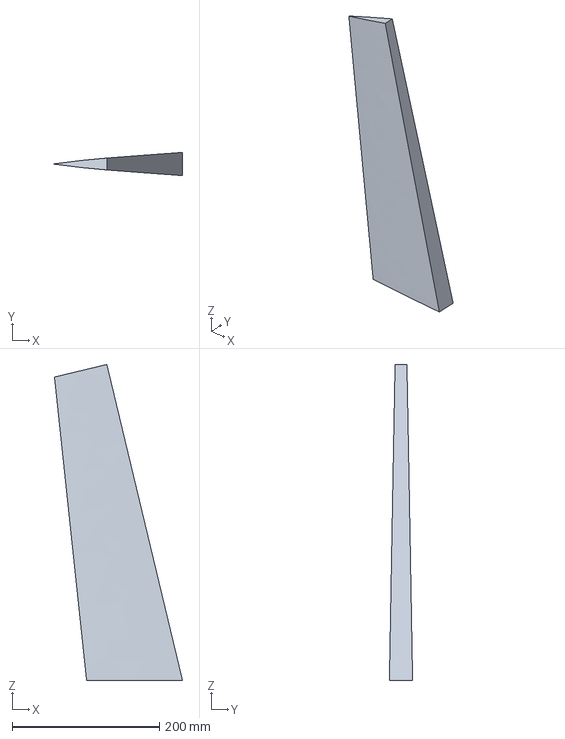
[picture p49: CAD file, 2026-10-05]
cl415/cad/parts/rudder.step
174.0 x 31.6 x 429.3 mm
