jamilchahineaub/FireFightingUAVF26-27/cl415/cad/parts/eq_battery.step

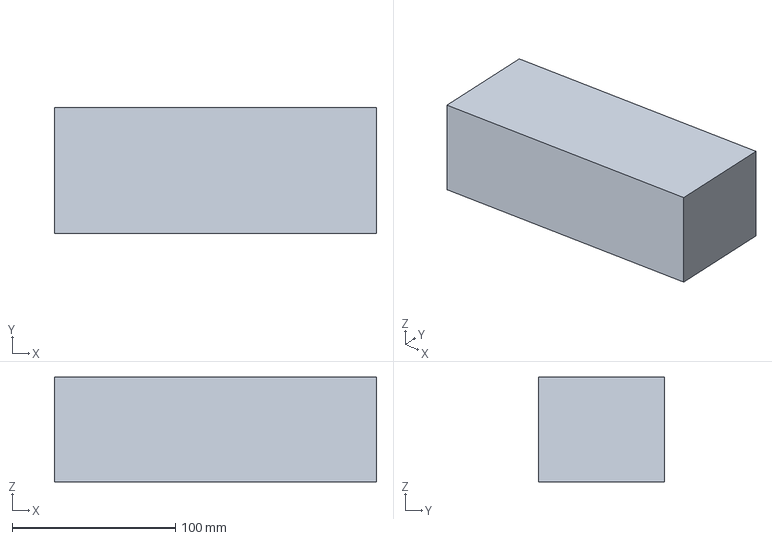
[picture p50: CAD file, 2026-10-05]
cl415/cad/parts/eq_battery.step
197.0 x 77.0 x 64.0 mm
