jamilchahineaub/FireFightingUAVF26-27/(list of files, cad)

Other CAD files:
cl415/cl415_description/meshes/right_float.stl
cl415/cad/parts/right_wing.step
cl415/cad/parts/eq_left_esc.step
cl415/cl415_description/meshes/left_aileron.stl
cl415/cad/parts/right_float.step
cl415/cl415_description/meshes/left_propeller.stl
cl415/cad/parts/eq_right_aileron_servo.step
cl415/cad/parts/eq_door_servo.step
cl415/cad/parts/right_nacelle.step
cl415/cad/parts/eq_left_motor.step
cl415/cad/parts/right_propeller.step
cl415/cad/parts/right_aileron.step
cl415/cad/parts/eq_rudder_servo.step
cl415/cad/parts/elevator.stl
cl415/cad/parts/eq_avionics.stl
cl415/cad/parts/eq_door_servo.stl
cl415/cad/parts/eq_elevator_servo.stl
cl415/cad/parts/eq_left_aileron_servo.stl
cl415/cad/parts/eq_left_esc.stl
cl415/cad/parts/eq_left_motor.stl
cl415/cad/parts/eq_right_aileron_servo.stl
cl415/cad/parts/eq_right_esc.stl
cl415/cad/parts/eq_right_motor.stl
cl415/cad/parts/eq_rudder_servo.stl
cl415/cad/parts/fuselage.stl
cl415/cad/parts/h_stab.stl
cl415/cad/parts/left_aileron.stl
cl415/cad/parts/left_float.stl
cl415/cad/parts/left_nacelle.stl
cl415/cad/parts/left_propeller.stl
cl415/cad/parts/left_wing.stl
cl415/cad/parts/right_aileron.stl
cl415/cad/parts/right_float.stl
cl415/cad/parts/right_nacelle.stl
cl415/cad/parts/right_propeller.stl
cl415/cad/parts/right_wing.stl
cl415/cad/parts/rudder.stl
cl415/cad/parts/v_stab.stl
cl415/cad/parts/water_3L.stl
cl415/cad/parts/water_tank.stl
cl415/cad/solidworks/cl415_assembly.SLDASM
cl415/cad/solidworks/parts/elevator.SLDPRT
cl415/cad/solidworks/parts/eq_avionics.SLDPRT
cl415/cad/solidworks/parts/eq_battery.SLDPRT
cl415/cad/solidworks/parts/eq_door_servo.SLDPRT
cl415/cad/solidworks/parts/eq_elevator_servo.SLDPRT
cl415/cad/solidworks/parts/eq_left_aileron_servo.SLDPRT
cl415/cad/solidworks/parts/eq_left_esc.SLDPRT
cl415/cad/solidworks/parts/eq_left_motor.SLDPRT
cl415/cad/solidworks/parts/eq_right_aileron_servo.SLDPRT
cl415/cad/solidworks/parts/eq_right_esc.SLDPRT
cl415/cad/solidworks/parts/eq_right_motor.SLDPRT
cl415/cad/solidworks/parts/eq_rudder_servo.SLDPRT
cl415/cad/solidworks/parts/fuselage.SLDPRT
cl415/cad/solidworks/parts/h_stab.SLDPRT
cl415/cad/solidworks/parts/left_aileron.SLDPRT
cl415/cad/solidworks/parts/left_float.SLDPRT
cl415/cad/solidworks/parts/left_nacelle.SLDPRT
cl415/cad/solidworks/parts/left_propeller.SLDPRT
cl415/cad/solidworks/parts/left_wing.SLDPRT
cl415/cad/solidworks/parts/right_aileron.SLDPRT
cl415/cad/solidworks/parts/right_float.SLDPRT
cl415/cad/solidworks/parts/right_nacelle.SLDPRT
cl415/cad/solidworks/parts/right_propeller.SLDPRT
cl415/cad/solidworks/parts/right_wing.SLDPRT
cl415/cad/solidworks/parts/rudder.SLDPRT
cl415/cad/solidworks/parts/v_stab.SLDPRT
cl415/cad/solidworks/parts/water_3L.SLDPRT
cl415/cad/solidworks/parts/water_tank.SLDPRT
