jamilchahineaub/FireFightingUAVF26-27/cl415/verify/out/ground_full.csv

t | x | y | z | roll | pitch | yaw | vx | vy | vz | left_aileron_joint_pos | right_aileron_joint_pos | elevator_joint_pos | rudder_joint_pos | left_propeller_joint_pos | right_propeller_joint_pos | left_aileron_joint_vel | right_aileron_joint_vel | elevator_joint_vel | rudder_joint_vel | left_propeller_joint_vel | right_propeller_joint_vel
0.0000 | 1.7460380063295517e-08 | 7.885705436164402e-14 | 0.3179400180423685 | -6.288388963433254e-13 | 1.7380256835920778e-07 | 2.063124944271525e-13 | 1.6503689517140664e-06 | 7.472139945991802e-12 | -0.15204389832990964 | 1.1514130888583442e-06 | 1.1514217345564364e-06 | 1.745215146888203e-06 | 5.2601181494723495e-14 | -7.761688391181639e-22 | 1.421749056671727e-21 | 0.00021918329015355745 | 0.00021918494985184505 | 0.00033375944486087284 | 7.838182847748694e-12 | -1.4456844945681817e-19 | 2.33659756386083e-19
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
