jamilchahineaub/FireFightingUAVF26-27/cl415/verify/out/water_actuate.csv

t | x | y | z | roll | pitch | yaw | vx | vy | vz | left_aileron_joint_pos | right_aileron_joint_pos | elevator_joint_pos | rudder_joint_pos | left_propeller_joint_pos | right_propeller_joint_pos | left_aileron_joint_vel | right_aileron_joint_vel | elevator_joint_vel | rudder_joint_vel | left_propeller_joint_vel | right_propeller_joint_vel
0.0000 | -0.008304854180604315 | 6.32514158393033e-07 | 0.24365316407707166 | -7.1816999265940735e-06 | -0.0299857979877115 | 3.0271402848247964e-07 | 0.011369971747628228 | 2.2472492529592083e-06 | 0.07664068353688507 | -0.0027048265598325068 | -0.002704341699880488 | -0.024600953907025897 | -7.292948856046393e-08 | -6.15928222883187e-10 | 1.1042433870170658e-09 | -0.16122276068613306 | -0.16122191659160937 | -0.2541188200670815 | -3.143383790321759e-07 | -7.929875865382661e-16 | 1.480238779721357e-15
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
