jamilchahineaub/FireFightingUAVF26-27/cl415/verify/out/water_empty_damped.csv

t | x | y | z | roll | pitch | yaw | vx | vy | vz | left_aileron_joint_pos | right_aileron_joint_pos | elevator_joint_pos | rudder_joint_pos | left_propeller_joint_pos | right_propeller_joint_pos | left_aileron_joint_vel | right_aileron_joint_vel | elevator_joint_vel | rudder_joint_vel | left_propeller_joint_vel | right_propeller_joint_vel
0.0000 | -9.795518425671501e-05 | 1.0876999098203642e-09 | 0.2892662578159538 | -1.7780144466377645e-08 | -0.0014893826410656919 | -8.98692265028464e-10 | -0.007317060691333572 | 8.139300745827224e-08 | -0.052766204040943884 | 0.005999213271734789 | 0.005999455373322304 | -0.0021096765132441087 | -2.3679920519930854e-08 | -7.998564701891894e-10 | 1.4359694218347353e-09 | 0.5182179765731236 | 0.5182380604940594 | -0.1441808894169121 | -1.959009678452656e-06 | -8.562308780285348e-16 | 1.5201835829644489e-15
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
