jamilchahineaub/FireFightingUAVF26-27/cl415/verify/out/water_full.csv

t | x | y | z | roll | pitch | yaw | vx | vy | vz | left_aileron_joint_pos | right_aileron_joint_pos | elevator_joint_pos | rudder_joint_pos | left_propeller_joint_pos | right_propeller_joint_pos | left_aileron_joint_vel | right_aileron_joint_vel | elevator_joint_vel | rudder_joint_vel | left_propeller_joint_vel | right_propeller_joint_vel
0.0000 | -0.00012024852931995163 | 1.048968677485318e-09 | 0.2887378398735154 | -1.117133280747885e-08 | -0.0011934987840143724 | -1.038051534365003e-09 | -0.008797055351472302 | 7.66431800514509e-08 | -0.09404989168517527 | 0.0031408534311036297 | 0.0031410187795931255 | -0.003770783160246333 | -2.0830243929578525e-08 | -6.159279091370725e-10 | 1.1042428409330042e-09 | 0.16201368953879378 | 0.16202211711842684 | -0.1984445519243139 | -1.0689127709767209e-06 | -1.8882966373633201e-16 | 3.2851648757621925e-16
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
