jamilchahineaub/FireFightingUAVF26-27/cl415/verify/out/water_full_damped.csv

t | x | y | z | roll | pitch | yaw | vx | vy | vz | left_aileron_joint_pos | right_aileron_joint_pos | elevator_joint_pos | rudder_joint_pos | left_propeller_joint_pos | right_propeller_joint_pos | left_aileron_joint_vel | right_aileron_joint_vel | elevator_joint_vel | rudder_joint_vel | left_propeller_joint_vel | right_propeller_joint_vel
0.0000 | -0.008885280261241763 | 7.510626417914376e-07 | 0.2452800247579599 | -8.909536004777656e-06 | -0.027859344860536865 | 3.750328539370811e-07 | -0.027859975138593823 | 2.9300844757221073e-06 | 0.019878435667591336 | nan | nan | nan | nan | nan | nan | nan | nan | nan | nan | nan | nan
0.0200 | -0.009704559425067394 | 8.161178557182024e-07 | 0.245263494903997 | -9.861007897475696e-06 | -0.032044118025378286 | 4.32326849038868e-07 | -0.04513942439459796 | 3.385048345959069e-06 | -0.005805321457791578 | -0.005351419221294342 | -0.005350886028991784 | -0.024759354984079922 | -2.1778120895721126e-08 | -6.159282707284857e-10 | 1.1042434775324937e-09 | 0.055077102663221356 | 0.05507754898617107 | 0.2148701563673613 | 2.018123143073871e-06 | -7.698365879030299e-16 | 1.477698951429015e-15
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
