jamilchahineaub/FireFightingUAVF26-27/cl415/px4_sitl/flight_logs/2026-10-03_21_53_10.png

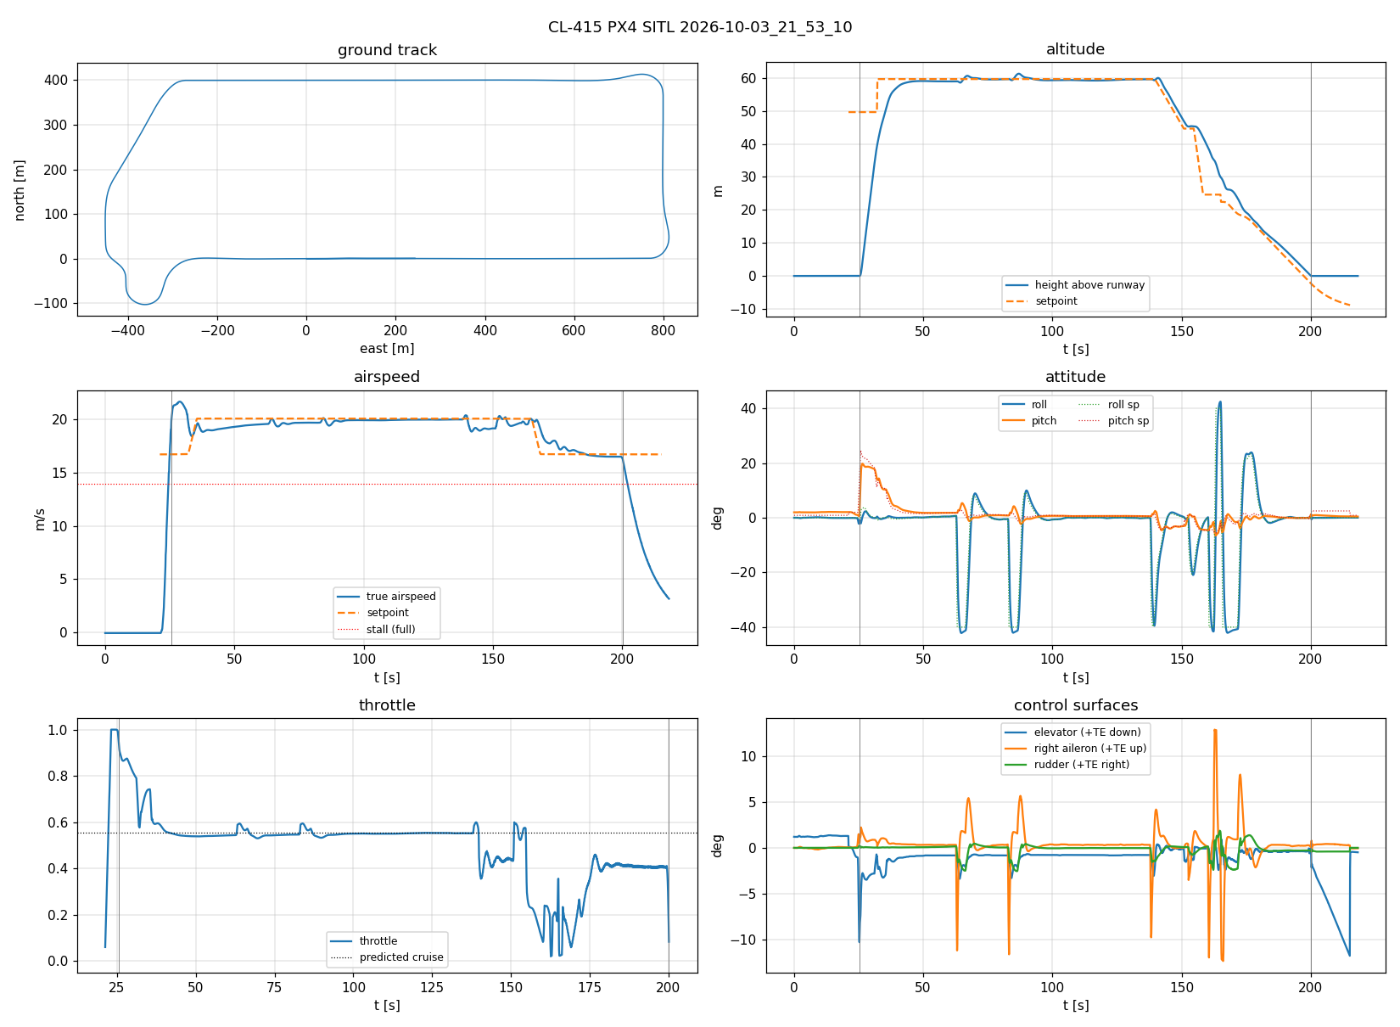
cl415/px4_sitl/flight_logs/2026-10-03_21_53_10.png
