jamilchahineaub/FireFightingUAVF26-27/cl415/px4_sitl/flight_logs/2026-10-03_22_47_23.png

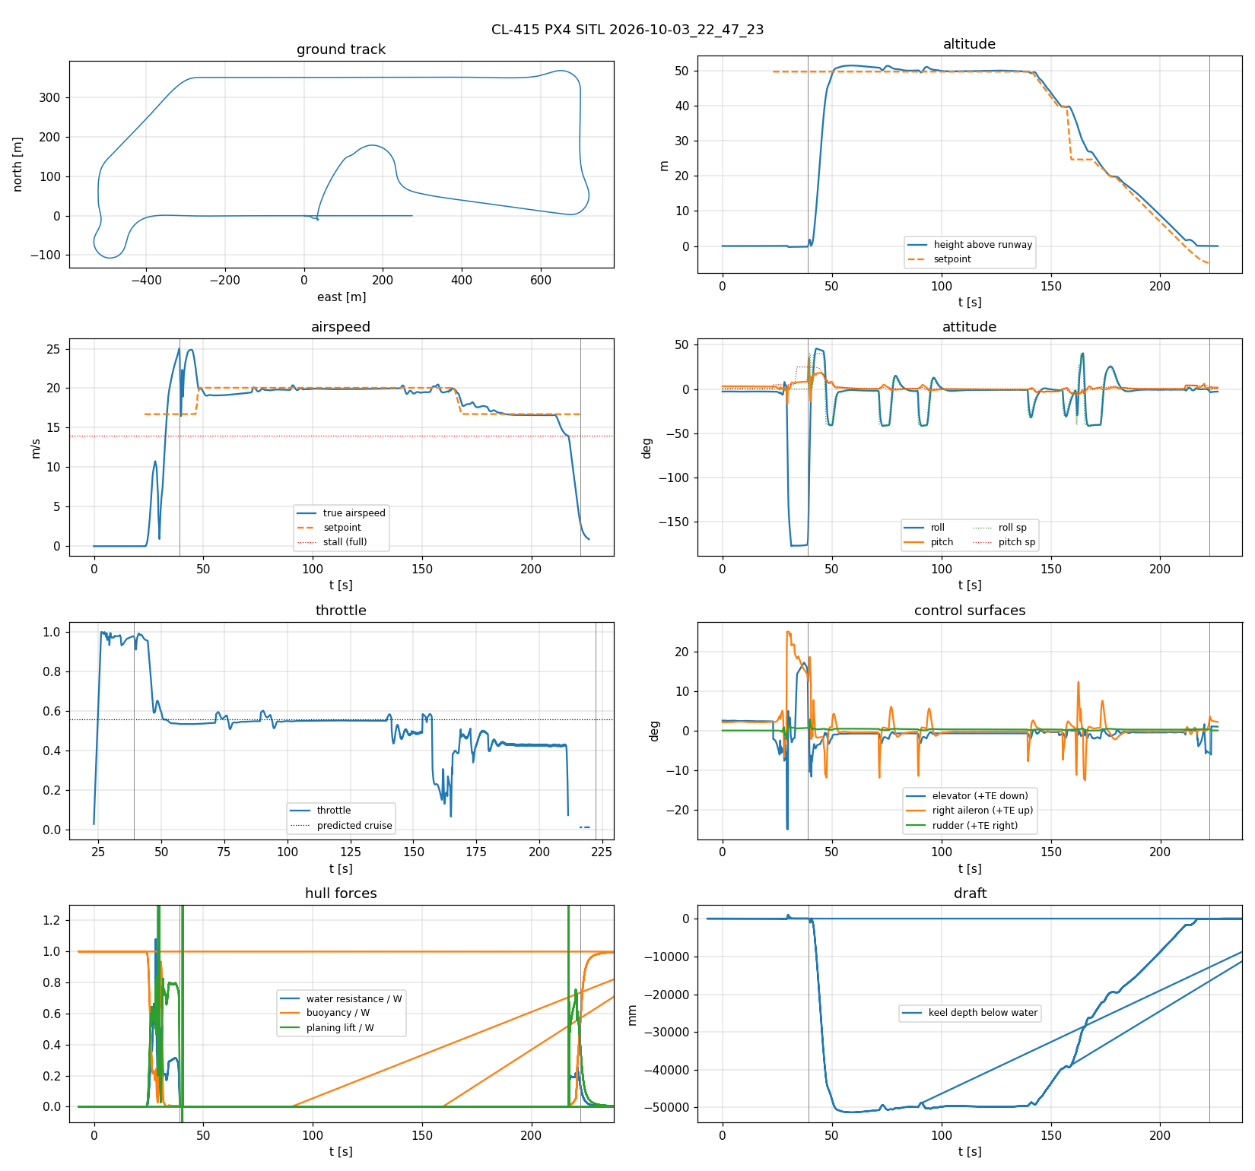
cl415/px4_sitl/flight_logs/2026-10-03_22_47_23.png
