jamilchahineaub/FireFightingUAVF26-27/cl415/px4_sitl/flight_logs/frame_rollout_2026-10-04_03-02.png

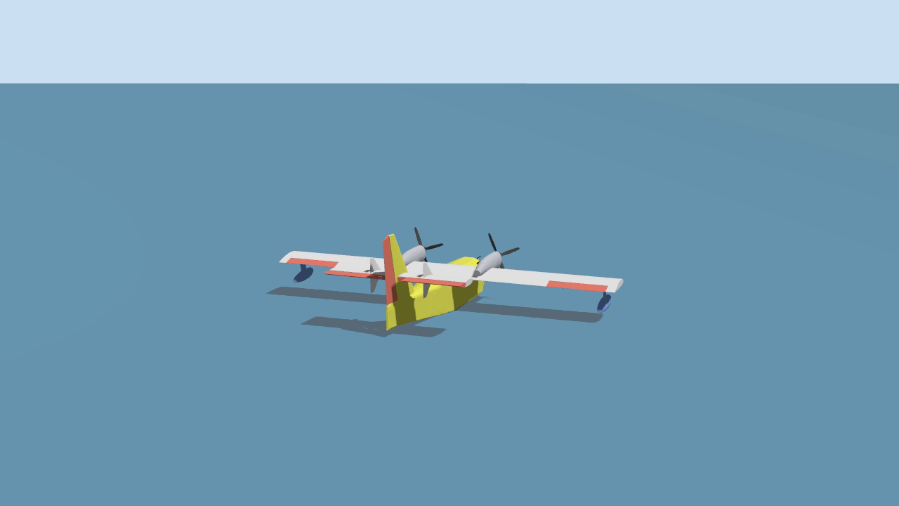
cl415/px4_sitl/flight_logs/frame_rollout_2026-10-04_03-02.png
