jamilchahineaub/FireFightingUAVF26-27/cl415/verify/plots/actuation.png

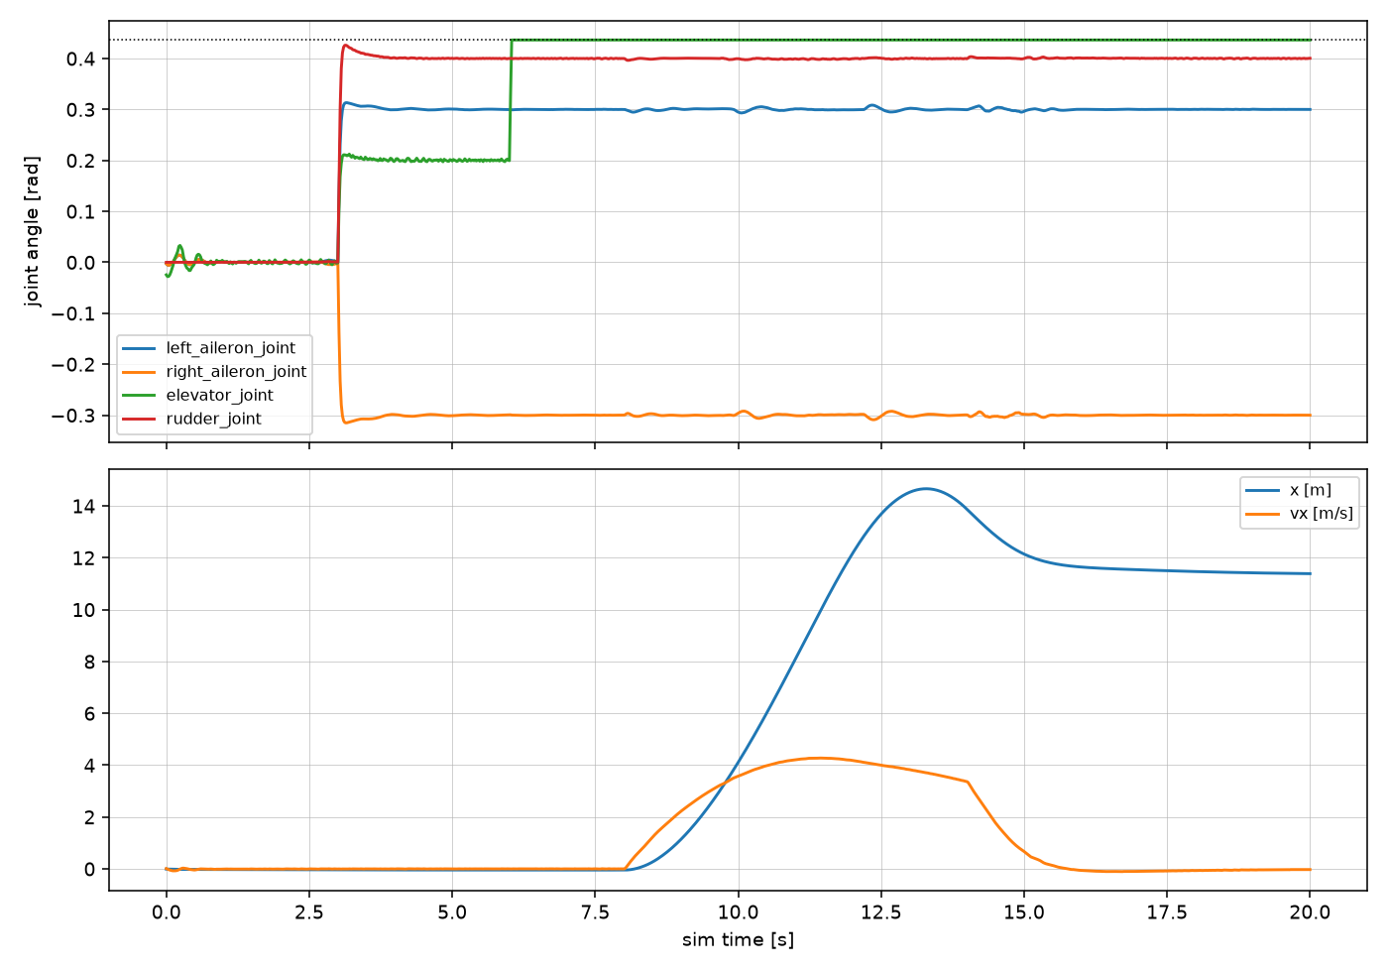
cl415/verify/plots/actuation.png
