jamilchahineaub/FireFightingUAVF26-27/cl415/verify/plots/ground.png

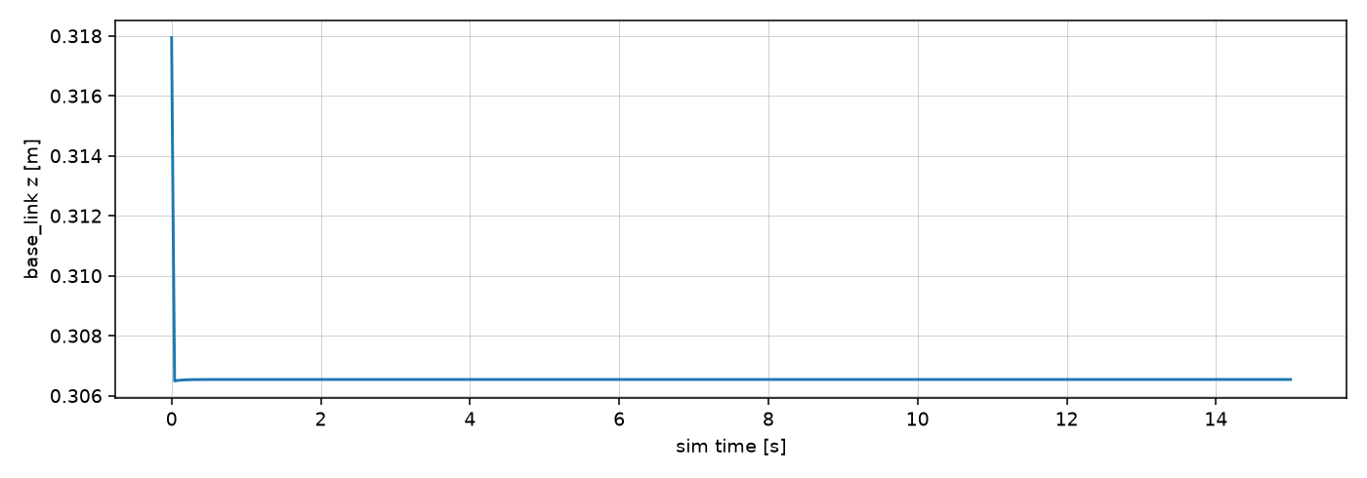
cl415/verify/plots/ground.png
