jamilchahineaub/FireFightingUAVF26-27/cl415/verify/plots/water.png

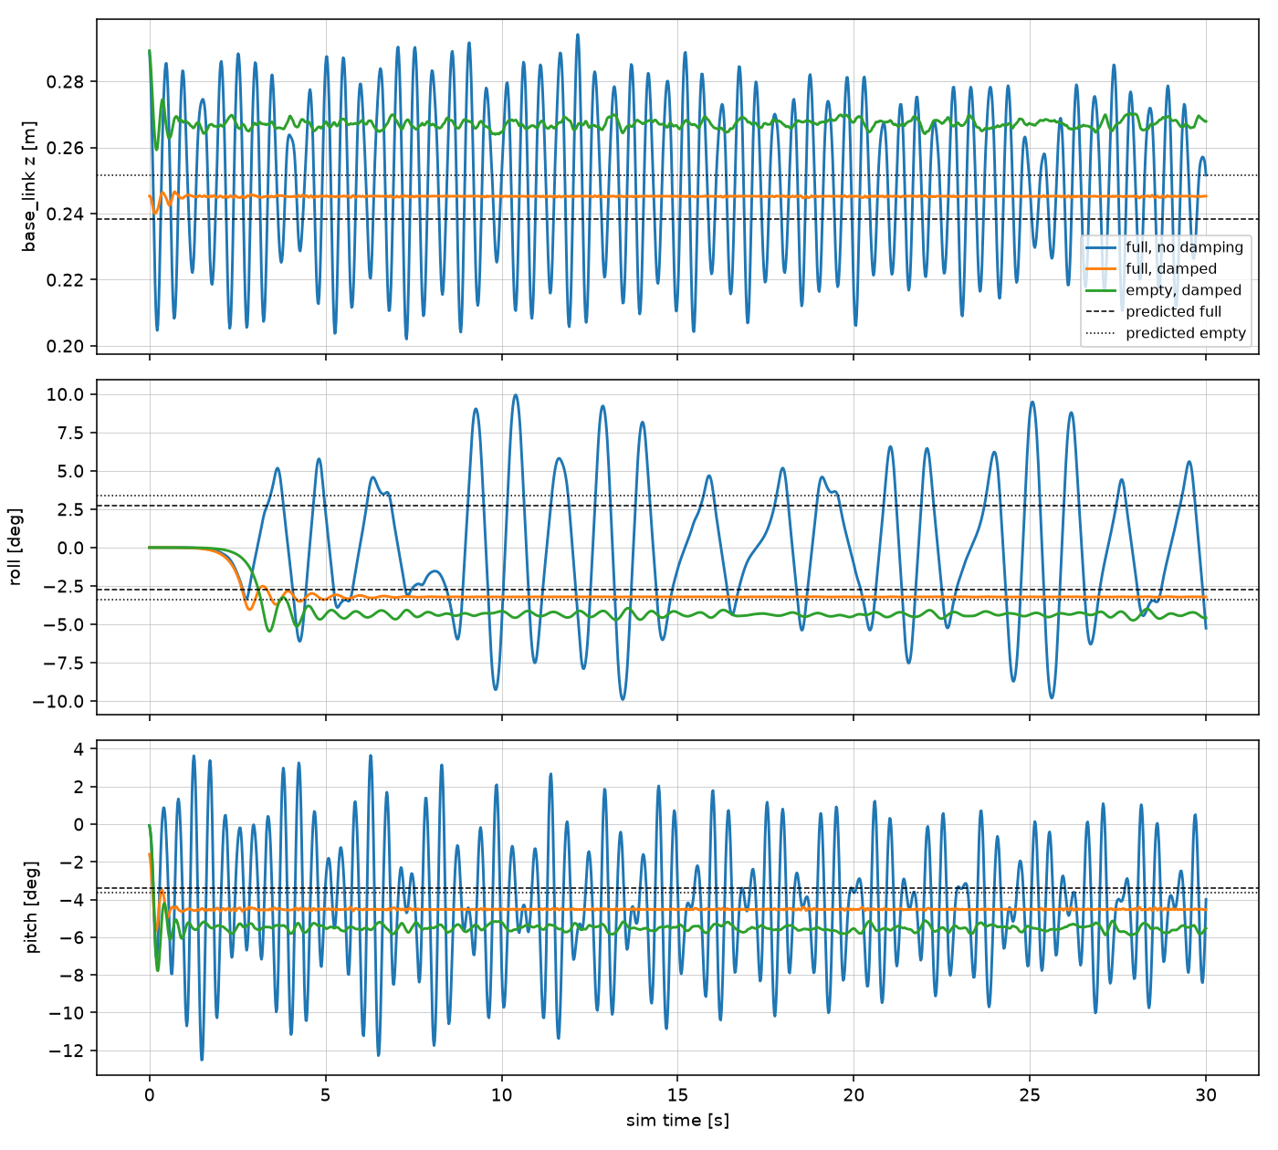
cl415/verify/plots/water.png
