jamilchahineaub/FireFightingUAVF26-27/cl415/verify/out/cl415_empty.urdf

<?xml version="1.0" ?>
<!-- =================================================================================== -->
<!-- |    This document was autogenerated by xacro from cl415_description/urdf/cl415.urdf.xacro | -->
<!-- |    EDITING THIS FILE BY HAND IS NOT RECOMMENDED                                 | -->
<!-- =================================================================================== -->
<!-- scaled CL-415 water bomber UAV: 2.51 m span, NACA 4417 wing, 10.5 kg with 3 L of water.
     frame REP-103: x forward, y left, z up, origin at the wing leading edge root (centreline).
     args:
       tank:=full|empty        water mass in or out (full 10.5 kg, empty 7.5 kg)
       water_damping:=false    adds a Hydrodynamics damper for float tests only (it also acts in air)
     numbers (inertia, collision boxes, joints, aero, motors) live in cl415_generated.xacro,
     written by tools/export_description.py from the SolidWorks mass properties and the aero script -->
<robot name="cl415">
  <!-- left_wing -->
  <gazebo>
    <plugin filename="gz-sim-lift-drag-system" name="gz::sim::systems::LiftDrag">
      <link_name>base_link</link_name>
      <air_density>1.225</air_density>
      <area>0.349018</area>
      <cp>-0.0694257 0.6275 -0.00321331</cp>
      <forward>1 0 0</forward>
      <upward>0 0 1</upward>
      <a0>0.118761</a0>
      <cla>4.84994</cla>
      <cda>0.427186</cda>
      <cma>0</cma>
      <alpha_stall>0.276698</alpha_stall>
      <cla_stall>-1.85638</cla_stall>
      <cda_stall>1.73344</cda_stall>
      <cma_stall>0</cma_stall>
      <control_joint_name>left_aileron_joint</control_joint_name>
      <control_joint_rad_to_cl>1.49813</control_joint_rad_to_cl>
      <cm_delta>-0.0520359</cm_delta>
    </plugin>
  </gazebo>
  <!-- right_wing -->
  <gazebo>
    <plugin filename="gz-sim-lift-drag-system" name="gz::sim::systems::LiftDrag">
      <link_name>base_link</link_name>
      <air_density>1.225</air_density>
      <area>0.349018</area>
      <cp>-0.0694257 -0.6275 -0.00321331</cp>
      <forward>1 0 0</forward>
      <upward>0 0 1</upward>
      <a0>0.118761</a0>
      <cla>4.84994</cla>
      <cda>0.427186</cda>
      <cma>0</cma>
      <alpha_stall>0.276698</alpha_stall>
      <cla_stall>-1.85638</cla_stall>
      <cda_stall>1.73344</cda_stall>
      <cma_stall>0</cma_stall>
      <control_joint_name>right_aileron_joint</control_joint_name>
      <control_joint_rad_to_cl>1.49813</control_joint_rad_to_cl>
      <cm_delta>-0.0520359</cm_delta>
    </plugin>
  </gazebo>
  <!-- h_stab -->
  <gazebo>
    <plugin filename="gz-sim-lift-drag-system" name="gz::sim::systems::LiftDrag">
      <link_name>base_link</link_name>
      <air_density>1.225</air_density>
      <area>0.223704</area>
      <cp>-0.87275 0 0.127</cp>
      <forward>1 0 0</forward>
      <upward>0 0 1</upward>
      <a0>-0.0617526</a0>
      <cla>2.2158</cla>
      <cda>0.215845</cda>
      <cma>0</cma>
      <alpha_stall>0.478461</alpha_stall>
      <cla_stall>-1.1079</cla_stall>
      <cda_stall>1</cda_stall>
      <cma_stall>0</cma_stall>
      <control_joint_name>elevator_joint</control_joint_name>
      <control_joint_rad_to_cl>2.14528</control_joint_rad_to_cl>
      <cm_delta>-0.0974998</cm_delta>
    </plugin>
  </gazebo>
  <!-- v_stab -->
  <gazebo>
    <plugin filename="gz-sim-lift-drag-system" name="gz::sim::systems::LiftDrag">
      <link_name>base_link</link_name>
      <air_density>1.225</air_density>
      <area>0.174408</area>
      <cp>-0.879768 0 0.155968</cp>
      <forward>1 0 0</forward>
      <upward>0 1 0</upward>
      <a0>0</a0>
      <cla>2.4169</cla>
      <cda>0.208619</cda>
      <cma>0</cma>
      <alpha_stall>0.401426</alpha_stall>
      <cla_stall>-1.20845</cla_stall>
      <cda_stall>1</cda_stall>
      <cma_stall>0</cma_stall>
      <control_joint_name>rudder_joint</control_joint_name>
      <control_joint_rad_to_cl>-1.2843</control_joint_rad_to_cl>
      <cm_delta>0.109399</cm_delta>
    </plugin>
  </gazebo>
  <gazebo>
    <plugin filename="gz-sim-multicopter-motor-model-system" name="gz::sim::systems::MulticopterMotorModel">
      <robotNamespace>cl415</robotNamespace>
      <jointName>left_propeller_joint</jointName>
      <linkName>left_propeller</linkName>
      <turningDirection>ccw</turningDirection>
      <timeConstantUp>0.0125</timeConstantUp>
      <timeConstantDown>0.025</timeConstantDown>
      <maxRotVelocity>890.118</maxRotVelocity>
      <motorConstant>4.2079e-05</motorConstant>
      <momentConstant>0.0299455</momentConstant>
      <commandSubTopic>command/motor_speed</commandSubTopic>
      <motorNumber>0</motorNumber>
      <rotorDragCoefficient>0.0001</rotorDragCoefficient>
      <rollingMomentCoefficient>1e-06</rollingMomentCoefficient>
      <rotorVelocitySlowdownSim>10</rotorVelocitySlowdownSim>
      <motorType>velocity</motorType>
    </plugin>
  </gazebo>
  <gazebo>
    <plugin filename="gz-sim-multicopter-motor-model-system" name="gz::sim::systems::MulticopterMotorModel">
      <robotNamespace>cl415</robotNamespace>
      <jointName>right_propeller_joint</jointName>
      <linkName>right_propeller</linkName>
      <turningDirection>cw</turningDirection>
      <timeConstantUp>0.0125</timeConstantUp>
      <timeConstantDown>0.025</timeConstantDown>
      <maxRotVelocity>890.118</maxRotVelocity>
      <motorConstant>4.2079e-05</motorConstant>
      <momentConstant>0.0299455</momentConstant>
      <commandSubTopic>command/motor_speed</commandSubTopic>
      <motorNumber>1</motorNumber>
      <rotorDragCoefficient>0.0001</rotorDragCoefficient>
      <rollingMomentCoefficient>1e-06</rollingMomentCoefficient>
      <rotorVelocitySlowdownSim>10</rotorVelocitySlowdownSim>
      <motorType>velocity</motorType>
    </plugin>
  </gazebo>
  <gazebo>
    <plugin filename="gz-sim-joint-position-controller-system" name="gz::sim::systems::JointPositionController">
      <joint_name>left_aileron_joint</joint_name>
      <topic>/cl415/cmd/left_aileron</topic>
      <p_gain>0.1691</p_gain>
      <i_gain>0.5411</i_gain>
      <d_gain>0.004228</d_gain>
      <i_max>0.15</i_max>
      <i_min>-0.15</i_min>
      <cmd_max>0.5</cmd_max>
      <cmd_min>-0.5</cmd_min>
    </plugin>
  </gazebo>
  <gazebo>
    <plugin filename="gz-sim-joint-position-controller-system" name="gz::sim::systems::JointPositionController">
      <joint_name>right_aileron_joint</joint_name>
      <topic>/cl415/cmd/right_aileron</topic>
      <p_gain>0.1691</p_gain>
      <i_gain>0.5411</i_gain>
      <d_gain>0.004228</d_gain>
      <i_max>0.15</i_max>
      <i_min>-0.15</i_min>
      <cmd_max>0.5</cmd_max>
      <cmd_min>-0.5</cmd_min>
    </plugin>
  </gazebo>
  <gazebo>
    <plugin filename="gz-sim-joint-position-controller-system" name="gz::sim::systems::JointPositionController">
      <joint_name>elevator_joint</joint_name>
      <topic>/cl415/cmd/elevator</topic>
      <p_gain>0.5155</p_gain>
      <i_gain>1.65</i_gain>
      <d_gain>0.01289</d_gain>
      <i_max>0.15</i_max>
      <i_min>-0.15</i_min>
      <cmd_max>0.5</cmd_max>
      <cmd_min>-0.5</cmd_min>
    </plugin>
  </gazebo>
  <gazebo>
    <plugin filename="gz-sim-joint-position-controller-system" name="gz::sim::systems::JointPositionController">
      <joint_name>rudder_joint</joint_name>
      <topic>/cl415/cmd/rudder</topic>
      <p_gain>0.4659</p_gain>
      <i_gain>1.491</i_gain>
      <d_gain>0.01165</d_gain>
      <i_max>0.15</i_max>
      <i_min>-0.15</i_min>
      <cmd_max>0.5</cmd_max>
      <cmd_min>-0.5</cmd_min>
    </plugin>
  </gazebo>
  <gazebo>
    <plugin filename="gz-sim-joint-state-publisher-system" name="gz::sim::systems::JointStatePublisher">
      <topic>/cl415/joint_states</topic>
    </plugin>
    <plugin filename="gz-sim-odometry-publisher-system" name="gz::sim::systems::OdometryPublisher">
      <odom_frame>odom</odom_frame>
      <robot_base_frame>base_link</robot_base_frame>
      <dimensions>3</dimensions>
      <odom_publish_frequency>50</odom_publish_frequency>
      <odom_topic>/cl415/odometry</odom_topic>
      <tf_topic>/cl415/tf</tf_topic>
    </plugin>
  </gazebo>
  <gazebo reference="base_link">
    <sensor name="imu" type="imu">
      <always_on>true</always_on>
      <update_rate>200</update_rate>
      <topic>/cl415/imu</topic>
    </sensor>
  </gazebo>
  <!-- hull on hard ground -->
  <gazebo reference="fuselage">
    <mu1>0.4</mu1>
    <mu2>0.4</mu2>
  </gazebo>
  <material name="cl415_yellow">
    <color rgba="0.95 0.80 0.10 1"/>
  </material>
  <material name="cl415_white">
    <color rgba="0.92 0.92 0.92 1"/>
  </material>
  <material name="cl415_red">
    <color rgba="0.85 0.20 0.15 1"/>
  </material>
  <material name="cl415_grey">
    <color rgba="0.55 0.57 0.62 1"/>
  </material>
  <material name="cl415_black">
    <color rgba="0.12 0.12 0.12 1"/>
  </material>
  <material name="cl415_blue">
    <color rgba="0.20 0.35 0.75 1"/>
  </material>
  <material name="cl415_tank">
    <color rgba="0.70 0.85 0.95 1"/>
  </material>
  <!-- root without inertia (keeps KDL quiet); every fixed part hangs off it and gets lumped into it in SDF -->
  <link name="base_link"/>
  <link name="fuselage">
    <visual>
      <origin rpy="0 0 0" xyz="0 0 0"/>
      <geometry>
        <mesh filename="package://cl415_description/meshes/fuselage.stl"/>
      </geometry>
      <material name="cl415_yellow"/>
    </visual>
    <collision name="fuselage_c0">
      <origin rpy="0 0 0" xyz="0.53251 0 -0.180291"/>
      <geometry>
        <box size="0.12502 0.111893 0.149215"/>
      </geometry>
    </collision>
    <collision name="fuselage_c1">
      <origin rpy="0 0 0" xyz="0.385 0 -0.151395"/>
      <geometry>
        <box size="0.17 0.199089 0.265143"/>
      </geometry>
    </collision>
    <collision name="fuselage_c2">
      <origin rpy="0 0 0" xyz="0.0799637 0 -0.161945"/>
      <geometry>
        <box size="0.440073 0.210101 0.289189"/>
      </geometry>
    </collision>
    <collision name="fuselage_c3">
      <origin rpy="0 0 0" xyz="-0.295036 0 -0.142785"/>
      <geometry>
        <box size="0.309927 0.197964 0.250871"/>
      </geometry>
    </collision>
    <collision name="fuselage_c4">
      <origin rpy="0 0 0" xyz="-0.6 0 -0.123921"/>
      <geometry>
        <box size="0.3 0.120182 0.213138"/>
      </geometry>
    </collision>
    <collision name="fuselage_c5">
      <origin rpy="0 0 0" xyz="-0.921249 0 -0.104179"/>
      <geometry>
        <box size="0.342498 0.0381242 0.169682"/>
      </geometry>
    </collision>
    <inertial>
      <origin rpy="0 0 0" xyz="-0.0505318 6.00182e-06 -0.116083"/>
      <mass value="4.485"/>
      <inertia ixx="0.0354423" ixy="6.60147e-06" ixz="0.0063311" iyy="0.511537" iyz="-3.80614e-06" izz="0.503799"/>
    </inertial>
  </link>
  <joint name="fuselage_joint" type="fixed">
    <parent link="base_link"/>
    <child link="fuselage"/>
    <origin rpy="0 0 0" xyz="0 0 0"/>
  </joint>
  <link name="left_wing">
    <visual>
      <origin rpy="0 0 0" xyz="0 0 0"/>
      <geometry>
        <mesh filename="package://cl415_description/meshes/left_wing.stl"/>
      </geometry>
      <material name="cl415_white"/>
    </visual>
    <collision name="left_wing_c0">
      <origin rpy="0 -0.0462512 0" xyz="-0.139351 0.6275 0.00437292"/>
      <geometry>
        <box size="0.278 1.255 0.04726"/>
      </geometry>
    </collision>
    <inertial>
      <origin rpy="0 0 0" xyz="-0.115004 0.628879 0.003662"/>
      <mass value="0.535"/>
      <inertia ixx="0.0679815" ixy="-0.000522223" ixz="-7.43268e-05" iyy="0.002095" iyz="-6.45825e-05" izz="0.0699311"/>
    </inertial>
  </link>
  <joint name="left_wing_joint" type="fixed">
    <parent link="base_link"/>
    <child link="left_wing"/>
    <origin rpy="0 0 0" xyz="0 0 0"/>
  </joint>
  <link name="right_wing">
    <visual>
      <origin rpy="0 0 0" xyz="0 0 0"/>
      <geometry>
        <mesh filename="package://cl415_description/meshes/right_wing.stl"/>
      </geometry>
      <material name="cl415_white"/>
    </visual>
    <collision name="right_wing_c0">
      <origin rpy="0 -0.0462512 0" xyz="-0.139351 -0.6275 0.00437292"/>
      <geometry>
        <box size="0.278 1.255 0.04726"/>
      </geometry>
    </collision>
    <inertial>
      <origin rpy="0 0 0" xyz="-0.11504 -0.628906 0.00366242"/>
      <mass value="0.535"/>
      <inertia ixx="0.067994" ixy="0.000523697" ixz="-7.43819e-05" iyy="0.00209416" iyz="6.42453e-05" izz="0.0699426"/>
    </inertial>
  </link>
  <joint name="right_wing_joint" type="fixed">
    <parent link="base_link"/>
    <child link="right_wing"/>
    <origin rpy="0 0 0" xyz="0 0 0"/>
  </joint>
  <link name="h_stab">
    <visual>
      <origin rpy="0 0 0" xyz="0 0 0"/>
      <geometry>
        <mesh filename="package://cl415_description/meshes/h_stab.stl"/>
      </geometry>
      <material name="cl415_white"/>
    </visual>
    <collision name="h_stab_c0">
      <origin rpy="0 0 0" xyz="-0.885 0 0.127"/>
      <geometry>
        <box size="0.144 0.936 0.03824"/>
      </geometry>
    </collision>
    <inertial>
      <origin rpy="0 0 0" xyz="-0.88188 1.76969e-06 0.12672"/>
      <mass value="0.14"/>
      <inertia ixx="0.00982238" ixy="-8.93621e-09" ixz="7.66785e-08" iyy="0.000219751" iyz="-3.80443e-08" izz="0.00994989"/>
    </inertial>
  </link>
  <joint name="h_stab_joint" type="fixed">
    <parent link="base_link"/>
    <child link="h_stab"/>
    <origin rpy="0 0 0" xyz="0 0 0"/>
  </joint>
  <link name="v_stab">
    <visual>
      <origin rpy="0 0 0" xyz="0 0 0"/>
      <geometry>
        <mesh filename="package://cl415_description/meshes/v_stab.stl"/>
      </geometry>
      <material name="cl415_yellow"/>
    </visual>
    <collision name="v_stab_c0">
      <origin rpy="0 0 0" xyz="-0.862743 2.99235e-05 0.19685"/>
      <geometry>
        <box size="0.351455 0.0470609 0.401706"/>
      </geometry>
    </collision>
    <inertial>
      <origin rpy="0 0 0" xyz="-0.881146 6.90123e-07 0.134975"/>
      <mass value="0.09"/>
      <inertia ixx="0.00120405" ixy="-7.84267e-09" ixz="0.000562919" iyy="0.00175931" iyz="-3.28778e-09" izz="0.000574887"/>
    </inertial>
  </link>
  <joint name="v_stab_joint" type="fixed">
    <parent link="base_link"/>
    <child link="v_stab"/>
    <origin rpy="0 0 0" xyz="0 0 0"/>
  </joint>
  <link name="left_nacelle">
    <visual>
      <origin rpy="0 0 0" xyz="0 0 0"/>
      <geometry>
        <mesh filename="package://cl415_description/meshes/left_nacelle.stl"/>
      </geometry>
      <material name="cl415_grey"/>
    </visual>
    <collision name="left_nacelle_c0">
      <origin rpy="0 0 0" xyz="-0.0391368 0.297303 0.0378546"/>
      <geometry>
        <box size="0.395904 0.0782232 0.126692"/>
      </geometry>
    </collision>
    <inertial>
      <origin rpy="0 0 0" xyz="0.104279 0.297299 0.0547296"/>
      <mass value="0.47"/>
      <inertia ixx="0.000312029" ixy="1.17201e-07" ixz="-8.73371e-05" iyy="0.00334735" iyz="6.43859e-08" izz="0.00326707"/>
    </inertial>
  </link>
  <joint name="left_nacelle_joint" type="fixed">
    <parent link="base_link"/>
    <child link="left_nacelle"/>
    <origin rpy="0 0 0" xyz="0 0 0"/>
  </joint>
  <link name="right_nacelle">
    <visual>
      <origin rpy="0 0 0" xyz="0 0 0"/>
      <geometry>
        <mesh filename="package://cl415_description/meshes/right_nacelle.stl"/>
      </geometry>
      <material name="cl415_grey"/>
    </visual>
    <collision name="right_nacelle_c0">
      <origin rpy="0 0 0" xyz="-0.0391368 -0.297297 0.0378546"/>
      <geometry>
        <box size="0.395904 0.0782232 0.126692"/>
      </geometry>
    </collision>
    <inertial>
      <origin rpy="0 0 0" xyz="0.104279 -0.297301 0.0547297"/>
      <mass value="0.47"/>
      <inertia ixx="0.000312085" ixy="1.15024e-07" ixz="-8.73381e-05" iyy="0.00334735" iyz="7.01611e-08" izz="0.00326712"/>
    </inertial>
  </link>
  <joint name="right_nacelle_joint" type="fixed">
    <parent link="base_link"/>
    <child link="right_nacelle"/>
    <origin rpy="0 0 0" xyz="0 0 0"/>
  </joint>
  <link name="left_float">
    <visual>
      <origin rpy="0 0 0" xyz="0 0 0"/>
      <geometry>
        <mesh filename="package://cl415_description/meshes/left_float.stl"/>
      </geometry>
      <material name="cl415_blue"/>
    </visual>
    <collision name="left_float_c0">
      <origin rpy="0 0 0" xyz="-0.0998906 1.1517 -0.141779"/>
      <geometry>
        <box size="0.257488 0.0370828 0.0804182"/>
      </geometry>
    </collision>
    <collision name="left_float_c1">
      <origin rpy="0 0 0" xyz="-0.1 1.1517 -0.0515695"/>
      <geometry>
        <box size="0.08 0.009 0.1"/>
      </geometry>
    </collision>
    <inertial>
      <origin rpy="0 0 0" xyz="-0.0799943 1.1517 -0.117561"/>
      <mass value="0.13"/>
      <inertia ixx="0.000273577" ixy="-3.63241e-08" ixz="-4.45738e-05" iyy="0.000950439" iyz="1.42658e-09" izz="0.000741465"/>
    </inertial>
  </link>
  <joint name="left_float_joint" type="fixed">
    <parent link="base_link"/>
    <child link="left_float"/>
    <origin rpy="0 0 0" xyz="0 0 0"/>
  </joint>
  <link name="right_float">
    <visual>
      <origin rpy="0 0 0" xyz="0 0 0"/>
      <geometry>
        <mesh filename="package://cl415_description/meshes/right_float.stl"/>
      </geometry>
      <material name="cl415_blue"/>
    </visual>
    <collision name="right_float_c0">
      <origin rpy="0 0 0" xyz="-0.0998906 -1.1517 -0.141779"/>
      <geometry>
        <box size="0.257488 0.0370828 0.0804182"/>
      </geometry>
    </collision>
    <collision name="right_float_c1">
      <origin rpy="0 0 0" xyz="-0.1 -1.1517 -0.0515695"/>
      <geometry>
        <box size="0.08 0.009 0.1"/>
      </geometry>
    </collision>
    <inertial>
      <origin rpy="0 0 0" xyz="-0.0799944 -1.1517 -0.117561"/>
      <mass value="0.13"/>
      <inertia ixx="0.000273577" ixy="-3.63075e-08" ixz="-4.45738e-05" iyy="0.000950439" iyz="1.43084e-09" izz="0.000741466"/>
    </inertial>
  </link>
  <joint name="right_float_joint" type="fixed">
    <parent link="base_link"/>
    <child link="right_float"/>
    <origin rpy="0 0 0" xyz="0 0 0"/>
  </joint>
  <!-- water tank: inside the hull, so no collision (it would count twice for buoyancy) -->
  <link name="water_tank">
    <visual>
      <origin rpy="0 0 0" xyz="0 0 0"/>
      <geometry>
        <mesh filename="package://cl415_description/meshes/water_tank.stl"/>
      </geometry>
      <material name="cl415_tank"/>
    </visual>
    <inertial>
      <origin rpy="0 0 0" xyz="-0.0694257 1.89626e-17 -0.187676"/>
      <mass value="0.25"/>
      <inertia ixx="0.00118536" ixy="0" ixz="0" iyy="0.00163559" iyz="0" izz="0.00197235"/>
    </inertial>
  </link>
  <joint name="water_tank_joint" type="fixed">
    <parent link="base_link"/>
    <child link="water_tank"/>
    <origin rpy="0 0 0" xyz="0 0 0"/>
  </joint>
  <link name="left_aileron">
    <visual>
      <origin rpy="0 0 0" xyz="0 0 0"/>
      <geometry>
        <mesh filename="package://cl415_description/meshes/left_aileron.stl"/>
      </geometry>
      <material name="cl415_red"/>
    </visual>
    <collision name="left_aileron_c0">
      <origin rpy="0 0 0" xyz="-0.028366 -3.70259e-14 0.000130868"/>
      <geometry>
        <box size="0.0816176 0.398 0.0249637"/>
      </geometry>
    </collision>
    <inertial>
      <origin rpy="0 0 0" xyz="-0.0183503 -1.26121e-13 -0.00255249"/>
      <mass value="0.035"/>
      <inertia ixx="0.000463292" ixy="0" ixz="-1.74855e-06" iyy="1.44088e-05" iyz="0" izz="0.00047514"/>
    </inertial>
  </link>
  <joint name="left_aileron_joint" type="revolute">
    <parent link="left_wing"/>
    <child link="left_aileron"/>
    <origin rpy="0 0 0" xyz="-0.208616 0.994 -0.00231168"/>
    <axis xyz="0 -1 0"/>
    <limit effort="2.0" lower="-0.436332" upper="0.436332" velocity="8.7"/>
    <dynamics damping="0.001" friction="0.0"/>
  </joint>
  <link name="right_aileron">
    <visual>
      <origin rpy="0 0 0" xyz="0 0 0"/>
      <geometry>
        <mesh filename="package://cl415_description/meshes/right_aileron.stl"/>
      </geometry>
      <material name="cl415_red"/>
    </visual>
    <collision name="right_aileron_c0">
      <origin rpy="0 0 0" xyz="-0.028366 -5.55112e-17 0.000130868"/>
      <geometry>
        <box size="0.0816176 0.398 0.0249637"/>
      </geometry>
    </collision>
    <inertial>
      <origin rpy="0 0 0" xyz="-0.0183503 -1.11577e-13 -0.00255249"/>
      <mass value="0.035"/>
      <inertia ixx="0.000463292" ixy="0" ixz="-1.74855e-06" iyy="1.44088e-05" iyz="0" izz="0.00047514"/>
    </inertial>
  </link>
  <joint name="right_aileron_joint" type="revolute">
    <parent link="right_wing"/>
    <child link="right_aileron"/>
    <origin rpy="0 0 0" xyz="-0.208616 -0.994 -0.00231168"/>
    <axis xyz="0 -1 0"/>
    <limit effort="2.0" lower="-0.436332" upper="0.436332" velocity="8.7"/>
    <dynamics damping="0.001" friction="0.0"/>
  </joint>
  <link name="elevator">
    <visual>
      <origin rpy="0 0 0" xyz="0 0 0"/>
      <geometry>
        <mesh filename="package://cl415_description/meshes/elevator.stl"/>
      </geometry>
      <material name="cl415_red"/>
    </visual>
    <collision name="elevator_c0">
      <origin rpy="0 0 0" xyz="-0.0402763 -2.77556e-17 -1.38778e-17"/>
      <geometry>
        <box size="0.109447 0.936 0.0289521"/>
      </geometry>
    </collision>
    <inertial>
      <origin rpy="0 0 0" xyz="-0.0250731 1.80306e-07 1.08467e-08"/>
      <mass value="0.06"/>
      <inertia ixx="0.004951" ixy="-2.74619e-11" ixz="6.46448e-11" iyy="4.28332e-05" iyz="1.98386e-10" izz="0.00498889"/>
    </inertial>
  </link>
  <joint name="elevator_joint" type="revolute">
    <parent link="h_stab"/>
    <child link="elevator"/>
    <origin rpy="0 0 0" xyz="-0.957 0 0.127"/>
    <axis xyz="0 -1 0"/>
    <limit effort="2.0" lower="-0.436332" upper="0.436332" velocity="8.7"/>
    <dynamics damping="0.001" friction="0.0"/>
  </joint>
  <link name="rudder">
    <visual>
      <origin rpy="0 0 0" xyz="0 0 0"/>
      <geometry>
        <mesh filename="package://cl415_description/meshes/rudder.stl"/>
      </geometry>
      <material name="cl415_red"/>
    </visual>
    <collision name="rudder_c0">
      <origin rpy="0 0 0" xyz="-0.0881958 -1.73472e-18 0.21965"/>
      <geometry>
        <box size="0.173997 0.0315507 0.4293"/>
      </geometry>
    </collision>
    <inertial>
      <origin rpy="0 0 0" xyz="-0.0801666 1.23625e-08 0.176709"/>
      <mass value="0.035"/>
      <inertia ixx="0.000478982" ixy="-2.58391e-10" ixz="9.1312e-05" iyy="0.000520003" iyz="-7.29896e-11" izz="4.30854e-05"/>
    </inertial>
  </link>
  <joint name="rudder_joint" type="revolute">
    <parent link="v_stab"/>
    <child link="rudder"/>
    <origin rpy="0 0 0" xyz="-0.956 0 -0.0173"/>
    <axis xyz="0.232882 0 -0.972505"/>
    <limit effort="2.0" lower="-0.523599" upper="0.523599" velocity="8.7"/>
    <dynamics damping="0.001" friction="0.0"/>
  </joint>
  <link name="left_propeller">
    <visual>
      <origin rpy="0 0 0" xyz="0 0 0"/>
      <geometry>
        <mesh filename="package://cl415_description/meshes/left_propeller.stl"/>
      </geometry>
      <material name="cl415_black"/>
    </visual>
    <collision name="left_propeller_c0">
      <origin rpy="0 0 0" xyz="0 0 0.01745"/>
      <geometry>
        <cylinder length="0.0589" radius="0.0296"/>
      </geometry>
    </collision>
    <inertial>
      <origin rpy="0 0 0" xyz="-9.92807e-07 2.05844e-07 0.00793929"/>
      <mass value="0.05"/>
      <inertia ixx="6.45217e-05" ixy="-4.17323e-11" ixz="-7.41765e-10" iyy="6.45246e-05" iyz="1.94693e-10" izz="0.000111037"/>
    </inertial>
  </link>
  <joint name="left_propeller_joint" type="continuous">
    <parent link="left_nacelle"/>
    <child link="left_propeller"/>
    <origin rpy="0 1.5708 0" xyz="0.1895 0.2973 0.0606"/>
    <axis xyz="0 0 1"/>
    <limit effort="10.0" velocity="200.0"/>
  </joint>
  <link name="right_propeller">
    <visual>
      <origin rpy="0 0 0" xyz="0 0 0"/>
      <geometry>
        <mesh filename="package://cl415_description/meshes/right_propeller.stl"/>
      </geometry>
      <material name="cl415_black"/>
    </visual>
    <collision name="right_propeller_c0">
      <origin rpy="0 0 0" xyz="0 0 0.01745"/>
      <geometry>
        <cylinder length="0.0589" radius="0.0296"/>
      </geometry>
    </collision>
    <inertial>
      <origin rpy="0 0 0" xyz="-2.1926e-07 -2.95184e-07 0.00793936"/>
      <mass value="0.05"/>
      <inertia ixx="6.45218e-05" ixy="1.39655e-09" ixz="-2.59661e-10" iyy="6.45338e-05" iyz="-1.62735e-10" izz="0.000111046"/>
    </inertial>
  </link>
  <joint name="right_propeller_joint" type="continuous">
    <parent link="right_nacelle"/>
    <child link="right_propeller"/>
    <origin rpy="0 1.5708 0" xyz="0.1895 -0.2973 0.0606"/>
    <axis xyz="0 0 1"/>
    <limit effort="10.0" velocity="200.0"/>
  </joint>
</robot>
