jamilchahineaub/FireFightingUAVF26-27/(commit log)

2026-09-28 Initial repository: params.yaml, 6-DOF model, trim, linearisation, modes, SDF generator, tests
    - params/params.yaml is the single source of truth (schema v1), converted to JSON for MATLAB
    - matlab/: eom (quaternion, full inertia), aero (stall blend calibrated to CL_max), propulsion
    (legacy constant-power + momentum), actuator, trim, static_trim, linearize, modes, tf_extract,
    run_six_points, px4_export stub
    - tests/: 9 tests, all passing under Octave 8.4 (make test-octave)
    - sim/gen_sdf.py: Jinja2 SDF generator with parse-back test
    - docs/decisions.md: D-01..D-06 (trim reference, propulsion inconsistency, PX4 gain conversion,
    stall calibration, lateral placeholders, inertia model)
    [params.yaml]
2026-09-28 Initial repository: params.yaml, 6-DOF model, trim, linearisation, modes, SDF generator, tests
    Co-A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
    [params.yaml]
2026-09-28 Fix README encoding (remove UTF-16 line appended by PowerShell)
2026-10-05 Add CL-415 UAV model, SolidWorks CAD and PX4 SITL work under cl415/
    [11x6-4_450kv_6S_battery_current_A.csv, 11x6-4_450kv_6S_battery_power_W.csv, 11x6-4_450kv_6S_rpm.csv, 11x6-4_450kv_6S_thrust_N.csv, 11x6-4_530kv_6S_battery_current_A.csv, 11x6-4_530kv_6S_battery_power_W.csv, 11x6-4_530kv_6S_rpm.csv, 11x6-4_530kv_6S_thrust_N.csv]
